boura01/jeu_du_moulin_2025_boura/README.md

c'est le projet Jeu du moulin pour les TPI 2025
voila.
