boura01/jeu_du_moulin_2025_boura/jeu_du_moulin_boura/cdc/readme.md

# Dossier "cahier-des-charges"

 Contient le cahier des charges du projet ainsi que toutes les informations nécessaire à sa compréhension.
