boura01/jeu_du_moulin_2025_boura/jeu_du_moulin_boura/fab/readme.md

# Dossier "project-fab-vx.x.x"

 Contient les fichiers de fabrication du projet.
 Ce répertoire ne contient que des fichier .pdf ou .zip.
 Tous les fichiers sont renommés avec la version de ceux-là.
 L'identification majeur et mineur sont tous identiques.
 Le majeur exprime la version du cahier-des-charges.
 Le mineur exprime la révision du PCB.
 Le patch est propre à chaque fichier indépendemment.

 example:
 
 projectname-pcb-schematic-v1.1.3.pdf
 projectname-pcb-layout-implantation-top-v1.1.0.pdf
 projectname-pcb-layout-implantation-bottom-v1.1.0.pdf
 projectname-pcb-gerber-v1.1.0.zip
 projectname-pcb-bom-v1.1.18.zip
 projectname-fwr-main-v1.1.4.zip
