boura01/jeu_du_moulin_2025_boura/jeu_du_moulin_boura/pcb/gerber/readme.md

# Dossier "gerber"

 Contient les derniers fichiers gerber créés.
