boura01/jeu_du_moulin_2025_boura/jeu_du_moulin_boura/pcb/pdf/readme.md

# Dossier "pdf"

 Contient les derniers fichiers pdf créés.
 
 example:
 
 projectname-pcb-schematic.pdf
 projectname-pcb-layout-top-implantation.pdf
 projectname-pcb-layout-top-implantation.pdf
