boura01/jeu_du_moulin_2025_boura/jeu_du_moulin_boura/rpt/datasheet/readme.md

# Dossier "datasheet"

 Contient tous les datasheets externes pour la création du projet.
 
 Un datasheet peut être utilisé pour du pcb, pour du fwr, pour du rpt, c'est pourquoi on place les datasheets dans ce répertoire spécifique
