boura01/jeu_du_moulin_2025_boura/jeu_du_moulin_boura/rpt/jeu-du-moulin-bourquenouda-rpt-development.docx

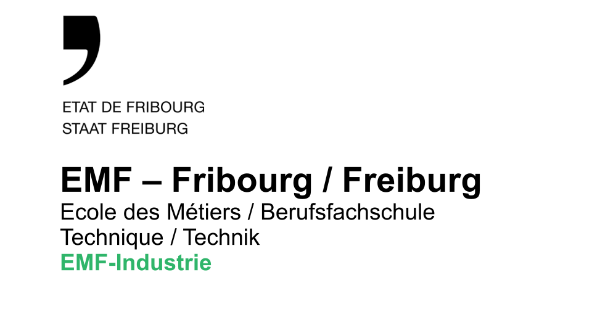
[picture p1: figure]

ELECTRONICIEN/NE CFC
ELEKTRONIKER/IN-EFZ

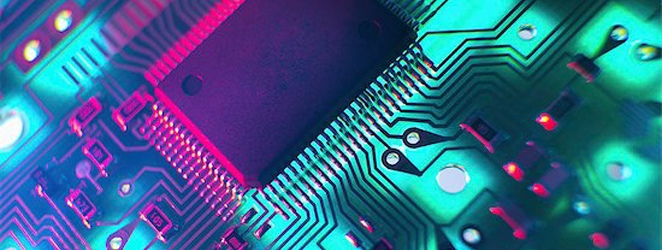
[picture p2: figure]
Le secteur de la technologie en Bourse

Jeu du Moulin 2025

V1.00

Jeu du moulin

Métier, Beruf

Bourquenoud Alexandre

2025

EMF - Ecole des Metiers de Fribourg

SWITZERLAND

# Table des matières

# 1 Information

## 1.1 Objectifs du projet

L’objectif de ce projet est de concevoir un prototype fonctionnel d’un PCB permettant de jouer au jeu du moulin. Cet objet pourra être utiliser par l’EMF pour promouvoir le métier d’électronicien pendant les journées portes ouvertes ou autre évenements. J’ai pu m’appuyer sur une première version du PCB non terminer créé par M.Egli pour pouvoir l’utiliser comme fondation du projet.

Pour démontrer le fonctionnement du projet, je ne suis pas tâché de recréer les règles du jeu du moulin en lui-même, mais plutôt de montrer que chaque touche et sa LED est fonctionnel.

### 1.1.1 Résumé du cahier des charges

Je dois créer le prototype du jeu du moulin sur PCB en continuant et finissant le travail commencer par M. Samuel Egli et créer un code pour démontrer le fonctionnement du prototype en lisant les touches et en allumant les LEDs en fonction des touches. La programmation de l’uC se fera grâce à un connecteur TC2030.

Pour ce faire je devrais adapter le schéma déjà fourni d’un STM32L072RBT à un MCU STM32L072CZU6 et rajouter les composants manquants en suivant certaines contraintes et la norme IEC 60617.

À cause du nombre insuffisant de pins de l’uC pour contrôler chaque touches et LEDs une part une, Je devrai utiliser 2 systèmes de matrices (une pour les LEDs et une pour les touches capacitives).

Je dois utiliser des composants SMD et des boitiers 0603 pour ne pas avoir d’agrandissement optique du montage.

Pour l’alimentation du circuit, je dois utiliser un USB-C ou une alimentation à 5V par 2 connecteurs et ensuite réguler la tension pour avoir un VCC = 3.3V.

Le PCB a des dimensions imposées de 10cm x 10xm mais ses dimensions peuvent être changées si nécessaire. La majorité du circuit de contrôle des touches et des LEDs sera placé sur la face BOTTOM au centre de la plaque pour l’esthétique qui est essentiel au projet.

## 1.2 Schéma de principe de l'environnement

### 1.2.1 Description des blocs principaux

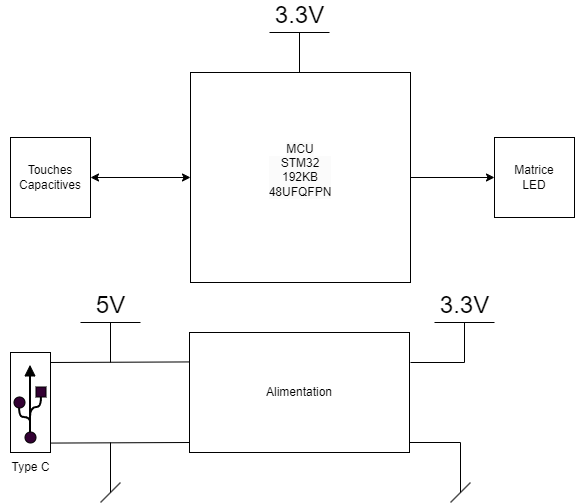
[picture p3: figure]

Le fonctionnement du projet est basé sur 4 parties principales.

1 : Touches capacitives.

Ces touches seront utilisées pour manipuler les pions des joueurs. Le but de mon projet n’étant pas d’avoir un jeu fonctionnel, elles ne serviront qu’a changer les LEDs d’état. Elles sont organisées en matrice pour pouvoir avoir plus de contrôle en utilisant moins d’IO.

2 : Microcontrôleur STM32L072CZU6

Ce microcontrôleur sera utilisé pour commander toutes les parties de l’objet. Contrairement au matériel utilisé d’habitude, celui-ci sera un STM32 et non un PIC.

3 : LEDs

Ces LEDs indiqueront le positionnement et l’équipe du joueurs. Elles seront contrôlées par l’IC et à l’aide des touches capacitives.

4 : Alimentation

Cette partie a comme entrée 5V venant soit d’un câble USB-C soit d’une alimentation de laboratoire et sortira 3.3V à l’aide d’un régulateur linéaire. J’ai aussi choisi d’inclure une protection de polarisation inverse en cas d’erreur de connexion de l’alimentation de laboratoire.

# 2 Planification

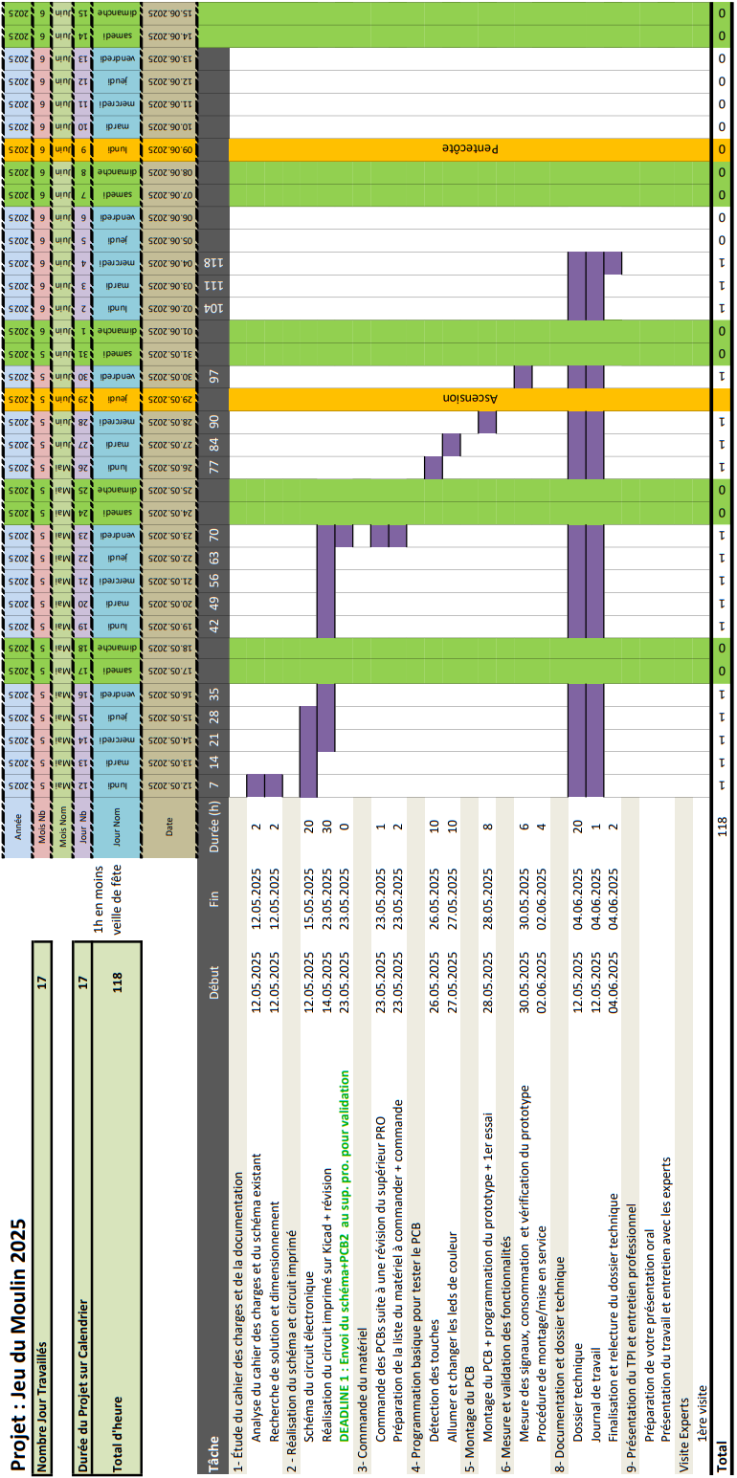
[picture p4: figure]

## 2.1 Calendrier prévisionnelle des tâches à réaliser

## 2.2 Calendrier réel des tâches réalisées

# 3 Décision

Date | Qui | Quoi | Pourquoi
13.05.2025 | Bourquenoud Alexandre, Egli Samuel, Cunha Fabio | Changement de boitier de l’µC | Pour avoir plus de place pendant le layout.
16.05.2025 | Bourquenoud Alexandre | Changement du type d’µC | Plus de stock pour l’autre microcontrôleur que j’utilisais.

# 4 Réalisation

## 4.1 Schéma bloc de l'électronique à développer

Pour le schéma bloc, je me suis inspiré de celui qui m’était imposer car il contient déjà la majorité des choses nécessaires. Le voici :

Changements si nécessaire :

J’ai uniquement modifié le bloc régulateur en alimentation car je compte y ajouter une protection de circuit en cas de polarisation inverse basée sur un MOSFET canal P.

## 4.2 Description des éléments principaux

### 4.2.1 Généralité sur les Touches Capacitives

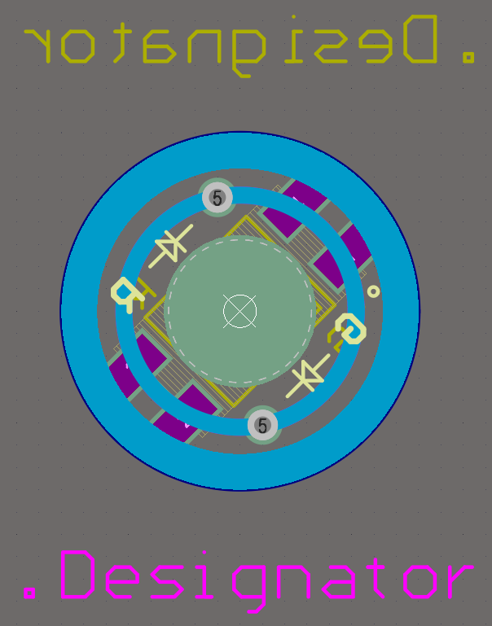
[picture p5: figure]

Elles sont créées directement sur le PCB à l’aide d’empreintes spécifiques qui engendre une capacité. Cette capacité variera si un doigt est présent sur la touche.

Pour détecter si la touche est pressée ou non on utilise un autre condensateur de valeur connue (Cs, Condensateur de sampling, ou échantillonnage en français).

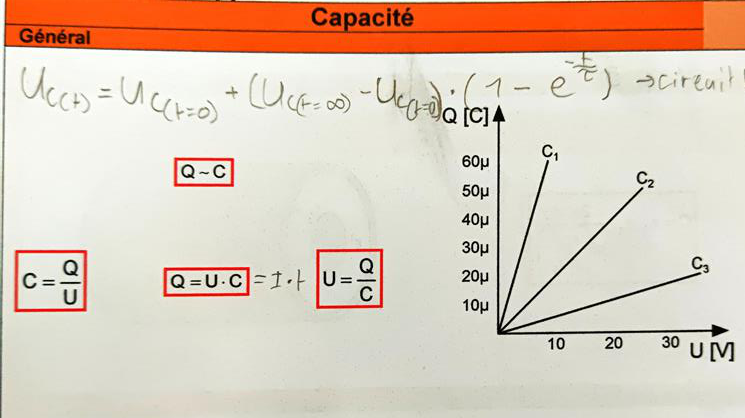
[picture p6: figure]

La méthode de détection est la suivante : On charge la capacité de la touche en la soumettant à une tension constante, puis on transfert cette charge sur le condensateur d’échantillonnage en fermant le circuit de manière que le condensateur chargé soit en série avec Cs. Après l’équilibrage des charges, on mesure la tension aux bornes de Cs et ou pourra déterminer si un doigt est présent sur la touche. Cette tension est ensuite passé à travers un CAN et est finalement interprété par le MCU en fonction des paramètre sélectionnés.

Avec cette formule, on peut voir la relation entre la tension, la capacité et les charges dans les condensateurs.

On a donc un schéma équivalent qui ressemble à peu près à ça :

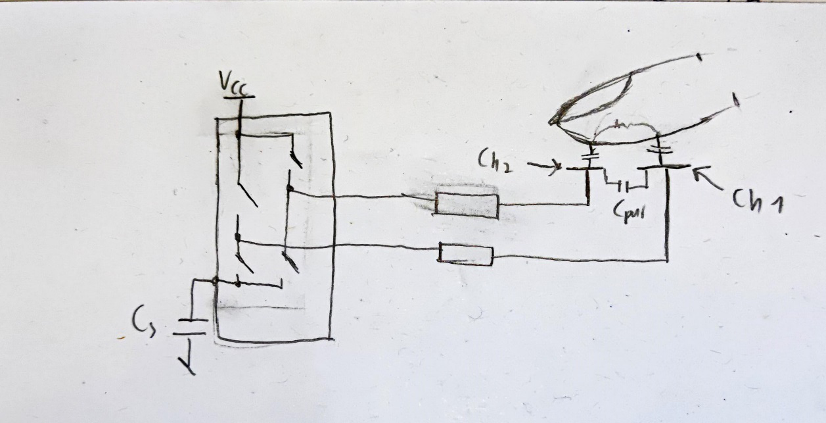
[picture p7: figure]

Ch1 et Ch2 sont les 2 anneaux présent sur l’empreinte du PCB, Cpar est la Capacité parasite et Cs est le condensateur de sampling.

On pourra donc voir que la tension UCs change en fonction de la capacité de la touche qui elle-même change en fonction de si la touche est pressée et aussi de qu’est ce qui presse sur la touche à cause de la constante diélectrique différente des matériaux.

Avec le système de matrice que nous utilisons, un problème peut se produire quand plusieurs touches des mêmes canaux sont pressées en même temps :

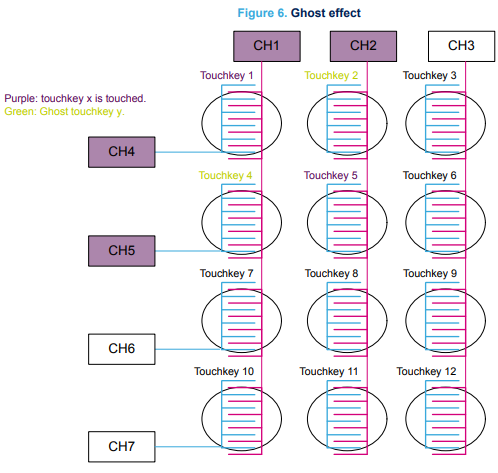
[picture p8: figure]

Dans cet exemple, la touche 1 et 5 est touché or le microcontrôleur ne peut pas différencier si les touches 1,2,4 ou 5 ont été pressé.

Ce problème est documenté par STMicroelectronics et dans notre cas ne sera pas trop important car dans le jeu, uniquement une touche doit être pressée à la fois.

Je voulais inclure un calcul de la capacité des touches, mais après une conversation avec M. Berset, je me suis rendu compte que ce n’était pas nécessaire au fonctionnement des touches et très bancal.

### 4.2.2 Généralité sur le MCU STM32 UFQFPN48

Le modèle de microcontrôleur imposé était "STM32L072CZT6" mais il a été changé quelques fois à cause de plusieurs raisons : le premier changement était dû à la taille et le deuxième a cause d’un manque de stocks. On a changé de boitier de LQFP48 à UFQFPN48 pour avoir plus d’espace de routage au centre du PCB ce qui nous a conduit au modèle "STM32L072CBU6". M.Egli utilisait ce MCU dans la programmation, ce qui convenait. Quand j’effectuais la recherche des composants pour la commande, je n’ai pas pu trouver le modèle utiliser dans le code de M.Egli alors j’ai choisi d’utiliser un modèle similaire après avoir vérifié la compatibilité ce qui nous a conduit au "STM32L072CZU6" qui fonctionne autant bien que les autres pour notre application. Avec une matrice, 24 touches donnent une utilisation de onze pins. Sur le MCU on a 6 groupes de touch sensing avec deux ou trois touches par groupes. Chaque groupe est composé de 4 pins dont un groupe ne contenant que 3 pins une de ces pins doit être utilisé pour le condensateur d’échantillonnage ce qui réduit le nombre de touches valables à trois et dans dans le cas du groupe à trois pins au total. J’ai donc employé 4 groupes de touch sensing pour les touches capacitives. Le PCB a une LED par touche donc on a aussi 24 LEDs qui seront organisé en matrice.

### 4.2.3 Généralité sur les LEDs AAA3528SURKCGKC09

Ces composants sont des LEDs bicolores de couleur rouge et vert produites par Kigbright. Elles sont utilisées pour montrer quel joueur est en possession de la case -> Rouge pour un joueur, vert pour l’autre et orange/rien quand la case est vide. Éteindre les LEDs quand la case est inoccupée pourrait s’avérer être une meilleure solution pour sauver des opérations du MCU. La LED rouge fonctionne avec une tension typique de 1.95V et un courant de 20mA, sa tension max est de 2.5V tandis que la LED verte consomme 20mA à 2.1V typ. Avec le même maximum de 2.5V. voici le Pinout du composant prit dans le datasheet.

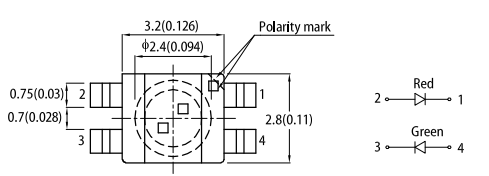
[picture p9: figure]

Idéalement, pas plus que deux LEDs (donc un de ces composant) seront allumé en même temps pour ne pas demander une consommation de courant trop élevée. Je vais utiliser un code que j’ai écris il y a un moment pour gérer les LEDs de façon qu’on ait l’impression que toutes les LEDs allumé le soit en même temps. Pour ce faire je dois simplement les allumer puis éteindre dans un ordre de manière plus rapide que la perception humaine. Je dois garder en tête que les touches capacitives sont aussi dépendantes d’une interruption donc il est possible que le fonctionnement correct de la matrice soit compromis.

## 4.3 Schématique, Dimensionnement & simulation

### 4.3.1 Schématique globale

J’ai aussi récupéré une schématique partiellement complète de Monsieur Egli mais il avait utilisé un autre IC que celui qui m’était imposer alors j’ai dû le changer. Ce schéma sera situé en annexe en cas de besoin de comparaison. Voici ci-après les schémas après mes changements avec des commentaires sur la raison des changements.

### 4.3.2 Changements Apportés au schéma de base

On peut voir que sur la première page, j’ai rassemblé les parties en groupes qui sont les même que dans le schéma bloc plus le connecteur TC2030 pour programmer le STM32L072CZU6 qui contrôlera la matrice de LEDs et de touches et que j’ai séparé les deux matrices sur deux pages différentes.

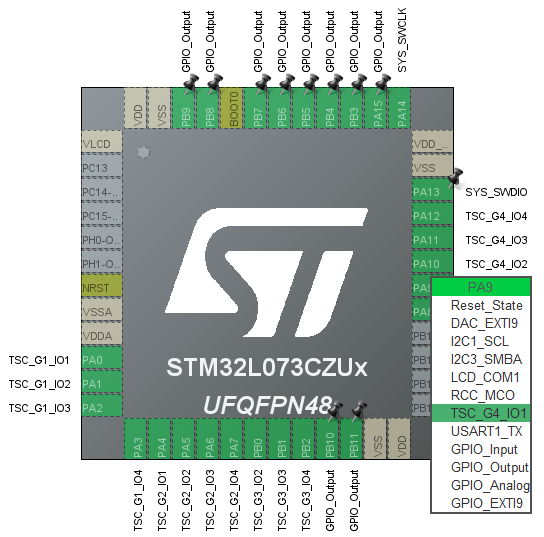
[picture p10: figure]

Groupe 1 : Microcontrôleur. Dans ce groupe, j’ai ajouté toutes les connexions des deux matrices et les condensateurs de découplage. J’ai été porté à faire des modifications dans la partie découplage pour être conforme aux instructions demandées par STMicroelectronics car le MCU imposé dans mon cahier des charges n’était pas le même que celui que M. Egli a utilisé dans le schéma de son prototype. J’ai contrôlé quelles pins sont valables à être utilisé à l’aide du logiciel STM32CubeIDE. Voici le paramétrage que j’ai utilisé pour voir si on avait assez de pins pour le jeu et pour voir quels pins étaient disponible.

On peut voir que les pins utilisés dans le schéma sont différents. C’est parce-que j’ai utilisé la méthode du pin-swapping sur Altium qui facilite le routage en me permettant de changer quelle pins est utiliser en les classant dans des groupes différents. Par exemple, toutes les pins des touches peuvent être interchangé car ce sera juste a la programmation qu’il faudra faire attention à quelle pin contrôle quoi. C’est pareil pour les LEDs, ce sera qu’au moment de la programmation que savoir quelle pin contrôle les colonnes ou les lignes de la matrice.

Avec ce panneau :

On peut voir comment la pin pourra être utiliser. J’ai donc utilisé ces informations pour savoir quels groupes faire. J’ai fait trois groupes (A, B et C) de pin-swapping. Le groupe A sert pour les 11 inputs des touches capacitives, le groupe B sert au contrôle de la matrice de LEDs et le groupe C est pour les condensateurs de sampling et les point de test. Comme je l’avais dit avant, toutes les pins de chaque groupes sont interchangeable car ce sera gérer niveau software donc je prends avantage de cette méthode pour faciliter le routage. Voici la fenêtre de pin-swapping :

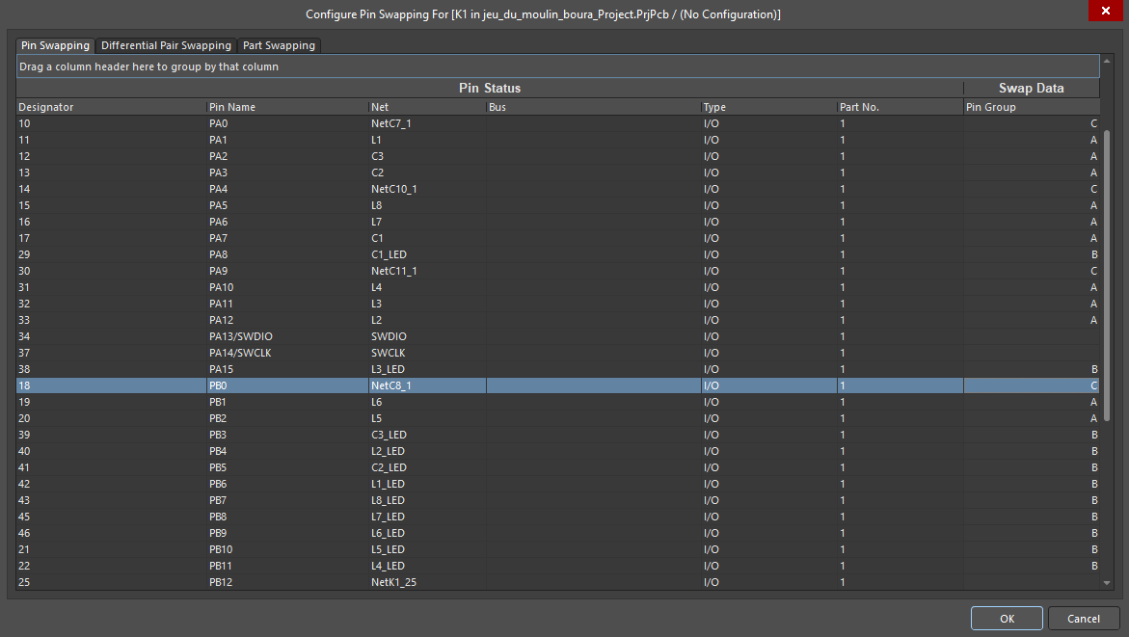
[picture p11: figure]

Un autre aspect qui diverge par rapport au schéma de base, c’est que j’ai rajouter des points de test TP3, 4, 5 et 6. Avec ces points, j’espère pouvoir mesurer les changements de tension quand on change la capacité en approchant sont doigt

Groupe 2 : Connecteur de programmation. Ce groupe n’existe pas dans le schéma bloc, mais il consiste juste des connexions nécessaires à la programmation du MCU. Cependant, le connecteur qu’on m’impose, un TC2030 qui demande juste des pads en surface et non un composant entier, n’est pas le même que celui du premier schéma et j’ai donc dû modifier cette partie du schéma.

Groupe 3 : Matrice de touches. Je n’ai pas apporté beaucoup de changements dans la matrice de touches, je l’ai simplement complété pour avoir les 24 touches nécessaires au fonctionnement du jeu du moulin.

Groupe 4 : Matrice de LEDs. Là aussi, j’ai simplement terminé la matrice de LEDs en suivant la même logique utilisée pour le schéma de M.Egli.

Groupe 5 : Alimentation. Cette partie était dans le schéma bloc mais absente dans le prototype de M.Egli et j’ai donc dû la créer entièrement. En lisant le cahier des charges on m’a dit qu’il fallait une tension d’alimentation de 5V réguler à 3.3V pour le MCU et le reste de la commande. J’ai donc cherché un régulateur qui serait utilisable et ensuite j’ai recherché des circuits de protection à la polarisation inversé. Un papier du fabricant Onsemi m’a été recommandé par mon frère au sujet des différent types de protection et je l’ai utilisé pour créer et dimensionné mon circuit de protection. Il est composé d’une diode zener, d’une résistance et d’un MOSFET canal P. Le fonctionnement est décrit dans l’article (AND90146 - MOSFET Selection for Reverse Polarity Protection (https://www.onsemi.com/download/application-notes/pdf/and90146-d.pdf)) mais globalement, en fonctionnement normale, Le MOSFET est polarisé par une tension imposée par la tension zener de la diode et le courant traversant la diode est lui-même limité par la résistance. En quand la polarité est inversée, la tension G-S du MOSFET serait bloqué à ~0.7V ce qui empêche le MOSFET de conduire et amène la chute de tension D-S à augmenter et empêche le circuit de subir une chute de tension inverse de plus de quelques microvolts. J’ai fait une simulation sur Falstad pour démontrer le fonctionnement du circuit de protection :

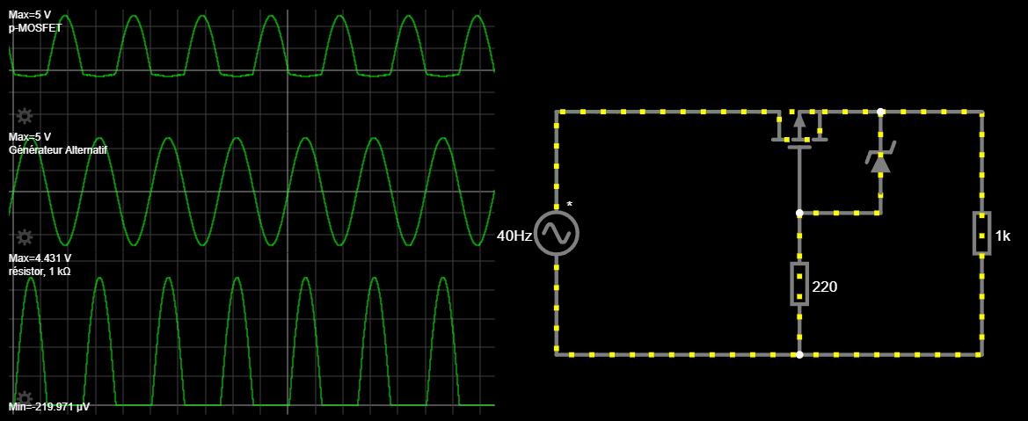
[picture p12: figure]

On peut donc voir sur la simulation que quand la tension du générateur est en alternance négative, la tension de la résistance de charge de 1kΩ ne passe jamais en dessous des -219.971µV et celle du MOSFET monte à 5V en revanche, entre le générateur et la charge, on a une chute de tension de 0.569V. Cette chute n’est pas très importante car 1 : elle dépend du MOSFET choisi et 2 : la tension de sortie du régulateur est de 3.3V.

Pour le connecteur USB-C il m’a fallut ajouter deux résistances de pull-down de 5.1kΩ sur les lignes CC pour signaler à la source de ne pas agir autrement que de fournir 5V et 500mA.

### 4.3.3 Dimensionnement

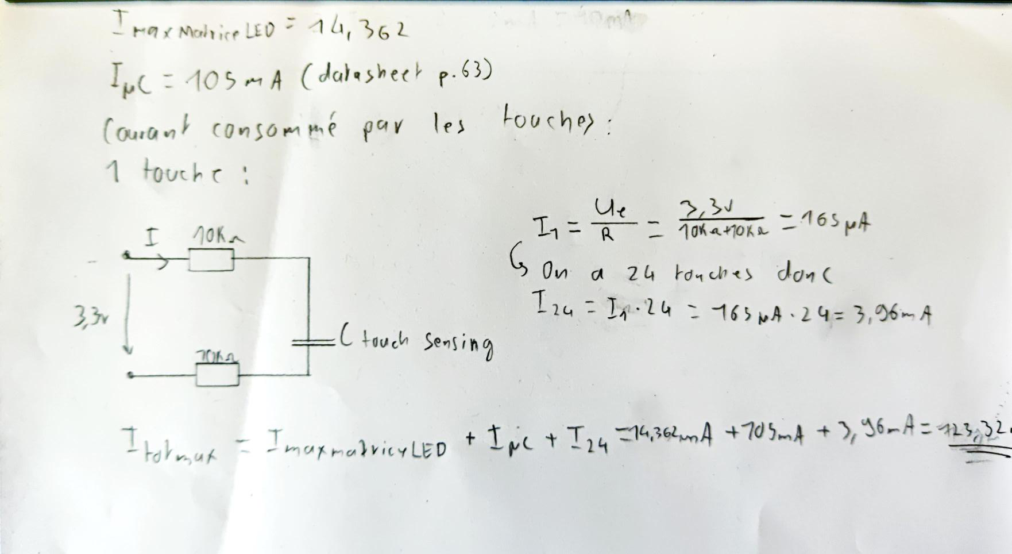
[picture p13: figure]

#### 4.3.3.1 Estimation du courant de consommation du système

J’ai estimé la consommation maximum de tout le circuit dans le pire cas possible en la séparant vers les principaux groupes de consommation. J’ai été forcé d’ignorer le condensateur de touch sensing car il est très difficile de calculer une valeur précise de sa capacité ce qui conduira forcément à des valeurs de calcul différentes de celle de mesure.

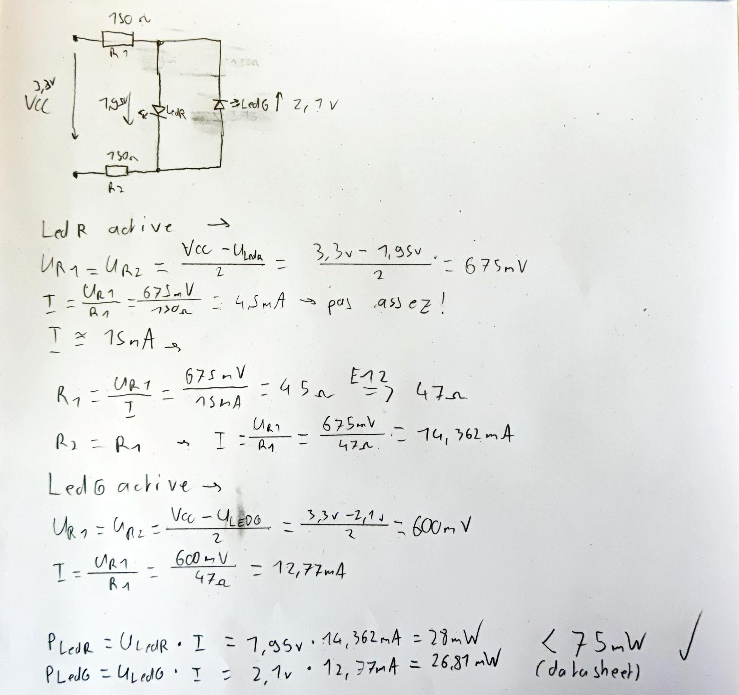
[picture p14: figure]

Et voici le calcul utilisé pour estimer la valeur du courant consommé par les LEDs :

#### 4.3.3.2 Régulateur de tension

La valeur en tension m’a été demandé à 3.3V mais j’ai dû calculer le courant maximum avant de pouvoir la mesurer. Je suis donc aller voir dans les cas extrêmes pour l’uC ce qui nous donne un courant max de 105mA (Datasheet - STM32L072x8 STM32L072xB STM32L072xZ - Ultra-low-power 32-bit MCU Arm®-based Cortex®-M0+, up to 192KB Flash, 20KB SRAM, 6KB EEPROM, USB, ADC, DACs (https://www.st.com/resource/en/datasheet/stm32l072v8.pdf) P.63). Les deux autres matrices utiliseront aussi du courant donc j’ai fait des calculs pour les cas extrêmes de leur côté aussi. Pour la matrice de LEDs, on pourra activer un maximum de 2 LEDs à la fois. Avec la matrice de touches, j’estime que toutes les touches tireront le courant maximum en tout temps.

Il me faudra donc un régulateur qui a la capacité de fournir plus de 146mA.

#### 4.3.3.3 Résistance pour le port USB-C

Il n’y a que 2 résistances sur le port USB-C car on l’utilise uniquement comme source et non pour effectuer des transferts de donnés. On m’a conseillé de regarder en ligne pour trouver la valeur des résistances qu’on doit utiliser comme pull-down. J’ai donc trouvé des informations sur un forum qui recommandais d’utiliser deux résistances de 5.1kΩ sur les 2 lignes de CC.

#### 4.3.3.4 Microcontrôleur

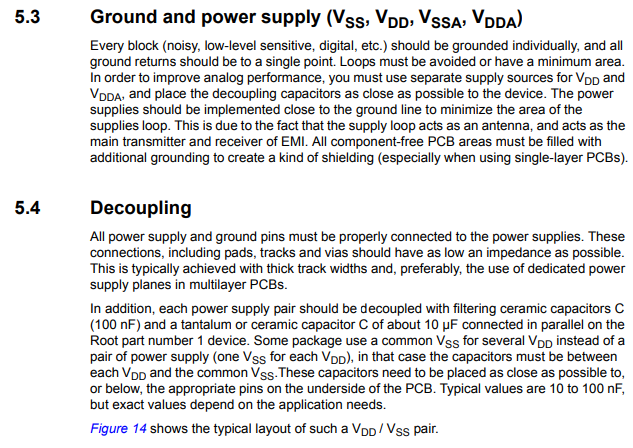
[picture p15: figure]

Pour le dimensionnement des condensateurs de découplage, toutes les informations nécessaires étaient fournies la documentation officielle de ST (Getting started with STM32L0xx hardware development (https://www.st.com/resource/en/application_note/an4467-getting-started-with-stm32l0xx-hardware-development-stmicroelectronics.pdf)):

##### 4.3.3.4.1 Port mapping

Pour le mapping des ports, j’ai regardé quelles pins était utilisé pour la programmation dans le datasheet et j’ai ensuite utilisé STM32CubeIDE pour savoir quelle pin pouvait être pour le touch sensing et j’ai assigné les pins restantes à la matrice de LEDs. Le mapping des LED a été fait avec le resultat du routage Altium car avec le pin-swapping utilisé pour convenir aux contraintes du cahier des charges on change facilement l’assignement des pins par rapport au schéma de base.

#### 4.3.3.5 Protection contre polarisation inverse

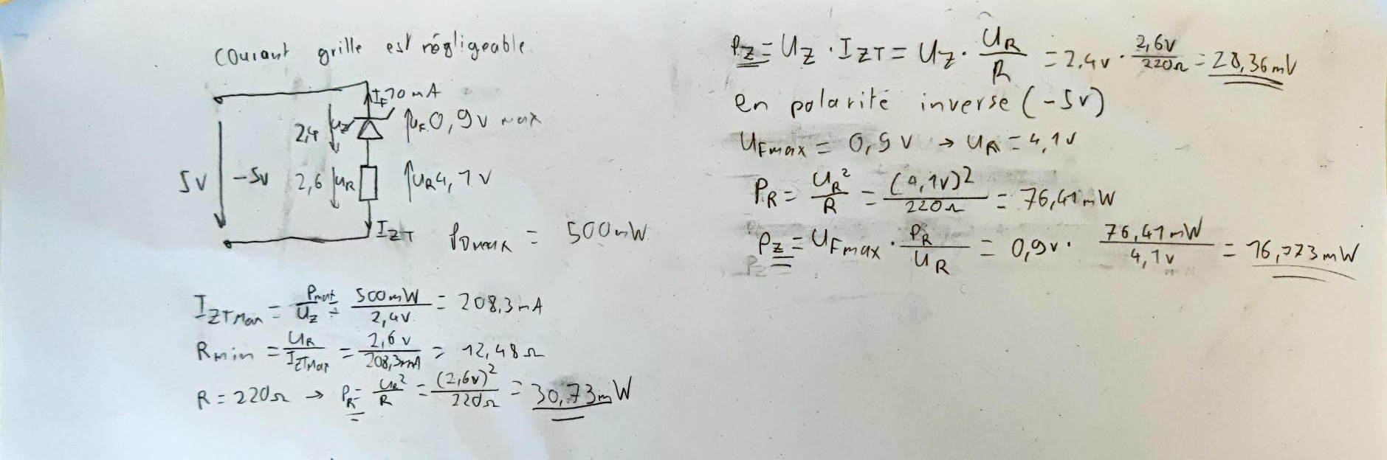
[picture p16: figure]
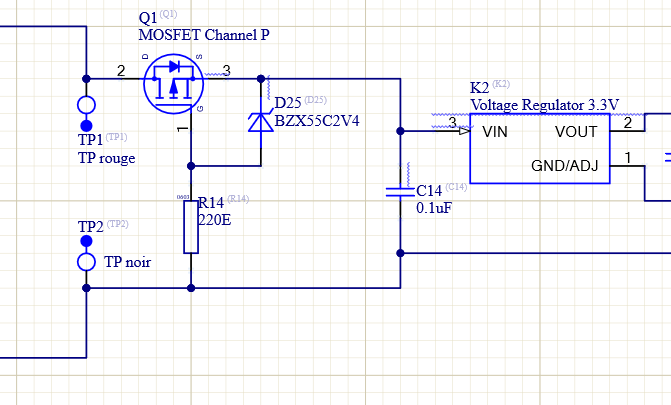
[picture p17: figure]

Pour la protection du circuit contre une polarisation inverse des TP1 et TP2, j’ai choisi d’utiliser un MOSFET channel P avec cette configuration :

Suggérer par le papier de ONSEMI sur la sélection des MOSFET pour la protection de polarisation inverse (AND90146 - MOSFET Selection for Reverse Polarity Protection (https://www.onsemi.com/download/application-notes/pdf/and90146-d.pdf))

J’ai donc du dimensionné la diode ZENER D25 et la résistance R14 pour qu’en polarisation correct, la Zener conduise et donc fait conduire le MOSFET en imposant la tension de seuil UGS sur la Grille et la source. En lisant le datasheet, j’ai choisi une diode Zener 2.4V 0.5W en boitier SOD-123 et j’ai simplifier le schéma de manière a pouvoir calculer R14.

## 4.4 Rédaction du protocole de mise en service du prototype

### 4.4.1 Protocole de mise en service

Etape | Quoi faire | Valeur attendue | Valeur mesurée | Erreur | Validée | Mes. Ref.
1 | Testez la continuité des GND | - | - | - | OK | -
2 | Implantez tous les composants SMD de la face BOTTOM | - | - | - | OK | -
3 | Vérifiez que le switch bloque la sortie du régulateur en vérifiant qu’il n’y ait pas de continuité entre TP7 et TP8 | Pas de beep | - | - | OK | -
4 | Alimentez le circuit par source de laboratoire en 5V. Sonde positive sur TP1 et sonde négative sur TP2. | - | - | - | OK | -
5 | Mesurez la tension de sortie du régulateur depuis le TP7 jusqu’au GND au TP2 | 3.3V | 3.270V | % | OK
6 | Vérifiez que le switch bloque la sortie du régulateur en vérifiant qu’il n’y ait pas de continuité entre TP7 et TP8 | Pas de beep | - | - | OK | -
7 | Alimentez le circuit par source de laboratoire en 5V. Sonde positive sur TP2 et sonde négative sur TP1 et mesurez la tension de sortie du régulateur depuis le TP7 jusqu’au GND au TP2 | 0V | 12.8mV | % | OK
8 | Déconnectez la source de laboratoire et braser le port USB-C. | - | - | - | OK | -
9 | Vérifiez que le switch n’est toujours pas fermé avec un test de continuité TP7 et TP8 | Pas de beep | - | - | OK
10 | Connectez un cable USB-C au port USB-C | - | - | - | OK | -
11 | Mesurez la tension TP1-TP2 | 5V | 5.15V | % | OK
12 | Mesurez la tension TP7-TP2 | 3.3V | 3.299 | % | OK
13 | Mesurez le courant TP7-TP8 | 8mA-123mA | | -
14 | Déconnectez le cable USB-C et changer actionner le switch S1 | - | - | - | | -
15 | Vérifiez que le switch est fermé avec un test de continuité entre TP7 et TP8 | beep | beep | - | OK | -
16 | Connectez le connecteur de programmation | - | - | - | OK | -
17 | Reconnectez le cable USB-C | - | - | - | OK | -
18 | Vérifiez qu’on peut connecter le PCB à STM32CubeID en lançant un debug | STM32CubeIDE ne donne pas de message d’erreur | Pas d’erreur si le debugger utilise le type Hardware reset et la fréquence 1000 au lieu d’auto | - | OK | -
19 | Lancez le debugger en mettant en commentaire les lignes concernant le contrôle des LEDs | STM32CubeIDE ne donne pas de message d’erreur | Problème de détection des touches | - | NOK | -
20 | Vérifiez dans le Live Expression de l’IDE que les touches fonctionnent en les pressant et observant s’il y a une réaction dans la variable de type tableau nommée touchDetect | La case du tableau correspondant à la touche doit changer de 0 à 1 quand on la presse. | Problème de détection des touches | - | | -
21 | Relancez le debugger en incluant les lignes concernant le contrôle des LEDs | STM32CubeIDE ne donne pas de message d’erreur | - | - | OK | -
22 | Vérifiez que les LEDs s’allument, changent de couleurs et s’éteignent quand les touches sont pressées, | Les LEDs fonctionnent correctement | Problème de détection des touches | - | NOK | -
23 | Lancez le programme de test de LEDs LED_TEST | La matrice de LEDs doit être fonctionnel. | - | - | OK | -

### 4.4.2 Mesure1

#### 4.4.2.1 But de la mesure

Cette mesure a comme but de nous donner la valeur du courant que le système consomme quand il effectue une détection des touches capacitives sur le prototype de M.Egli.

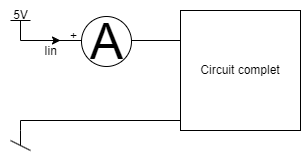
[picture p18: figure]

#### 4.4.2.2 Schéma de mesure

#### 4.4.2.3 Liste des instruments et leurs réglages

Instrument | Modele | Réglage
Alimentation de laboratoire | Xantrex XPL 30-2T Triple DC Power Supply | 3.3V, 300mA
multimètre | Amprobe 34XR-A | Courant DC mA

#### 4.4.2.4 Tableaux des valeurs mesurées

Iin = 8mA

#### 4.4.2.5 Conclusion

La valeur mesurée diffère grandement de la valeur calculée car le prototype de M.Egli n’as pas le même nombre de touches actives en même temps et la capacité des touches ne peut pas être calculé avec précision.

### 4.4.3 Mesure2

#### 4.4.3.1 But de la mesure

Cette mesure a comme but de nous donner la valeur du courant que le système consomme quand il effectue une détection des touches capacitives sur mon prototype.

#### 4.4.3.2 Schéma de mesure

#### 4.4.3.3 Liste des instruments et leurs réglages

Instrument | Modele | Réglage
Alimentation de laboratoire | Xantrex XPL 30-2T Triple DC Power Supply | 3.3V, 300mA
multimètre | Amprobe 34XR-A | Courant DC mA

#### 4.4.3.4 Tableaux des valeurs mesurées

Iin = 7.53mA

#### 4.4.3.5 Conclusion

On peut voir que la valeur mesurée de la consommation de courant des touches est très différente que celle de l’estimation ce qui me porte à croire que le calcul de courant est faux à noter que 2 des 8 lignes (L2 et L3) ne sont pas fonctionnelles au moment de la mesure.

### 4.4.4 Mesure3

#### 4.4.4.1 But de la mesure

Cette mesure a comme but de nous donner la valeur du courant que le système consomme quand il effectue une détection des touches capacitives et que le nombre maximum de LEDs (18) sont allumées sur mon prototype.

#### 4.4.4.2 Schéma de mesure

#### 4.4.4.3 Liste des instruments et leurs réglages

Instrument | Modele | Réglage
Alimentation de laboratoire | Xantrex XPL 30-2T Triple DC Power Supply | 3.3V, 300mA
multimètre | Amprobe 34XR-A | Courant DC mA

#### 4.4.4.4 Tableaux des valeurs mesurées

Iin = 11.34mA

#### 4.4.4.5 Conclusion

On peut voir que l’estimation du courant consommé est bien trop élevé et que le système ne consomme pas grand-chose quand le nombre maximum de LEDs sont allumées. En faisant la mesure sur le circuit, on peut observer un clignotement des LEDs.

## 4.5 Liste de matériel

Voici la Bom du projet :

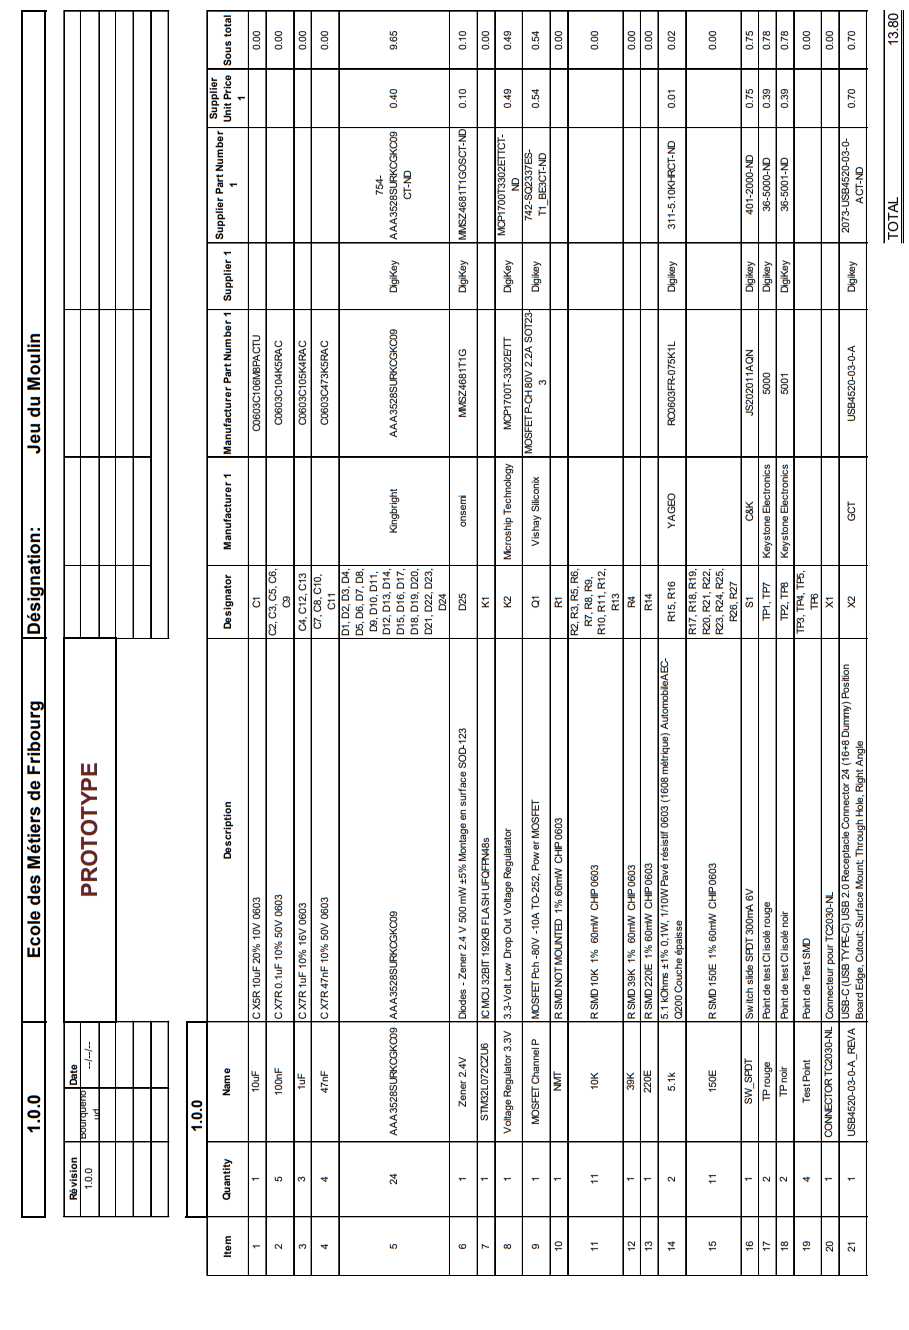
[picture p19: figure]

## 4.6 Layout

Pour le layout, J’ai d’abord placé les composant qui avaient une position imposée par le cahier des charges donc les 24 touches capacitives et leurs LEDs qui doivent être arrangé comme un plateau de jeu pour le moulin, le STM32 qui doit être au centre du PCB, le port USB-C qui doit être dans un bord et le connecteur de programmation qui dois être dans un bord aussi. Après ces composants j’ai dû réfléchir de manière a ce que tous les composants soient placé logiquement -> les condensateurs près des IC (le STM32 et le régulateur) qu’ils découplent, les résistances des matrices doivent être placé logiquement par rapport à leur pin sur le µC tout ça en faisant attention à laisser assez de place pour que les pistes atteignent les pins du STM32.

Ma méthode était la suivante : après avoir placé les composant qui avait une position obligatoire, j’ai collé les condensateurs de découplage le plus proche possible de leurs IC pour ensuite router les touches capacitives entre elles ce qui me permet de savoir quels endroits ne pourront pas être utilisé pour des pistes sur la face TOP. J’ai ensuite routé toute la partie alimentation dans un bord de plaque mais j’ai dû déplacer le switch par la suite. Après avoir router l’alimentation, j’ai relié les touches au MCU en amenant les résistances liées à la colonne ou ligne une part une. J’ai finalisé le routage par faire la même chose pour la matrice de LED. J’ai par la suite dû changer ou passait les pistes de contrôle des LEDs pour ne pas interférer avec les touches capacitives en faisant passer le signal haute fréquence de dessous de celles-ci.

Voici le layout complet (j’ai caché les 2 plans pour une meilleur lisibilité) suivi de quelques commentaires sur le placement des composants.

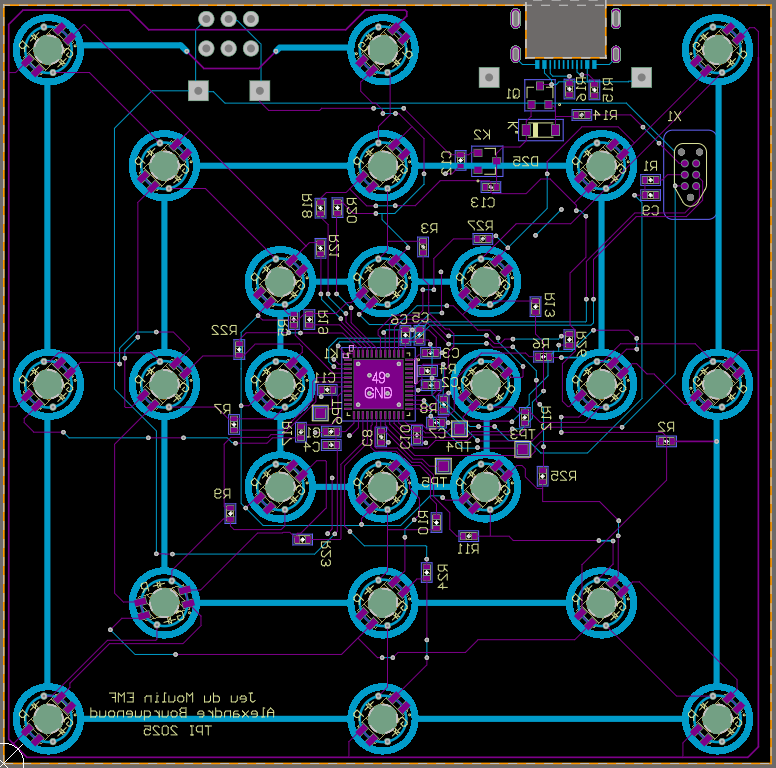
[picture p20: figure]
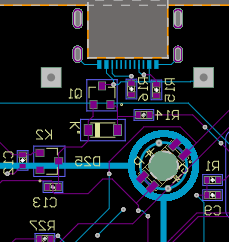
[picture p21: figure]

J’ai placé la partie alimentations près du ports USB-C car il y avait de l’espace dans le routage de la colonne C1 des touches capacitives. On peut y voir le MOSFET canal P , la diode Zener et le régulateur.

Pour la partie microcontrôleur, on a tous les condensateurs de découplage proche du STM32.

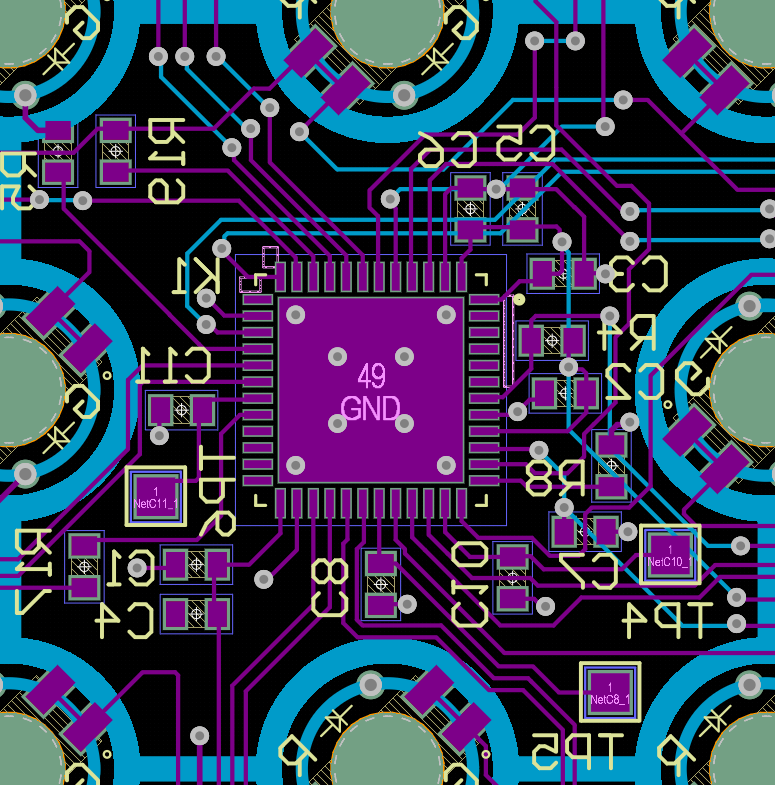
[picture p22: figure]

### 4.6.1 Contraintes (Rules Check)

#### 4.6.1.1 Largeurs des pistes de cuivre

Pour les largeurs de piste, j’ai essayé de suivre la logique de M.Egli en utilisant majoritairement l’épaisseur de 0.16mm pour les pistes des couches BOTTOM et TOP

#### 4.6.1.2 Diamètres des vias

J’ai utilisé 2 types de vias provenant de la bibliothèque de l’EMF. Les 2 ont le même diamètre et la seule différence est qu’une des deux est tented et a donc une couche de solder mask qui ne laisse pas le cuivre à l’air libre.

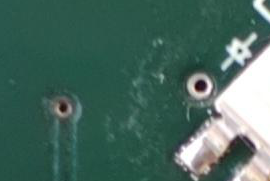
[picture p23: figure]
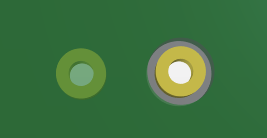
[picture p24: figure]

Tented non Tented

Tented non Tented

Le diamètre de ces vias est de 0.60mm

### 4.6.2 Empreintes spécifiques

La majorité des empreintes utile à ce projet ont été prise depuis la base de données de l’EMF ou depuis divers sites comme SnapEDA. Avant d’utilisé les empreintes, je les ai toutes mesuré sur Altium pour vérifier si elles étaient conformes à leurs dimensions sur le datasheet des composants correspondant.

J’avais besoin d’utiliser une empreinte spéciale fournie par M.Egli qui fera office de touche et LED à la fois en comportant une touche (donc 2 canaux) sur la face TOP et une LED (https://eduetatfr-my.sharepoint.com/personal/alexandre_bourquenoud_studentfr_ch/Documents/PHIE/jeu_du_moulin_alexandre_bourquenoud/jeu_du_moulin_2025_boura/je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) sur la face BOTTOM. Il y a un trou au milieu de l’empreinte pour pouvoir voir l’émetteur de la LED.

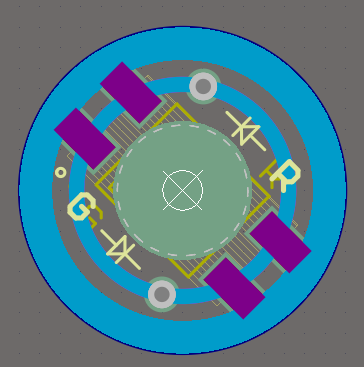
[picture p25: figure]
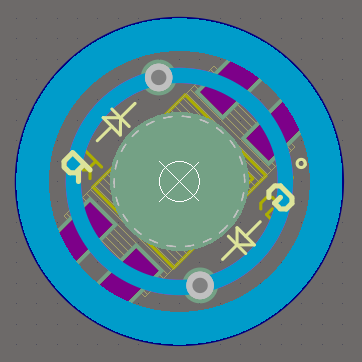
[picture p26: figure]

Face BOTTOM : LED bicolore

Face TOP : 2 canaux des touches capacitives

#### 4.6.2.1 Régulateur de tension

Le régulateur de tension (https://eduetatfr-my.sharepoint.com/personal/alexandre_bourquenoud_studentfr_ch/Documents/PHIE/jeu_du_moulin_alexandre_bourquenoud/jeu_du_moulin_2025_boura/je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) est contenu dans un boitier SOT-23 et est placé dans le coin ou la colonne C1 des touches capacitives n’est pas relié avec le reste et toute la partie alimentation (protection de polarisation inverse, condensateurs de découplage) est basée sur le positionnement du régulateur de tension linéaire 3.3V.

#### 4.6.2.2 Microcontrôleur

Le microcontrôleur STM32L072CZU6 est placé au centre du PCB avec ses condensateurs de découplage placé le plus près possible pour avoir une bonne efficacité. En changeant de boitier pour le µC (de LQFN48 à UFQFPN48), on arrive a gagner une bonne quantité de place au centre.

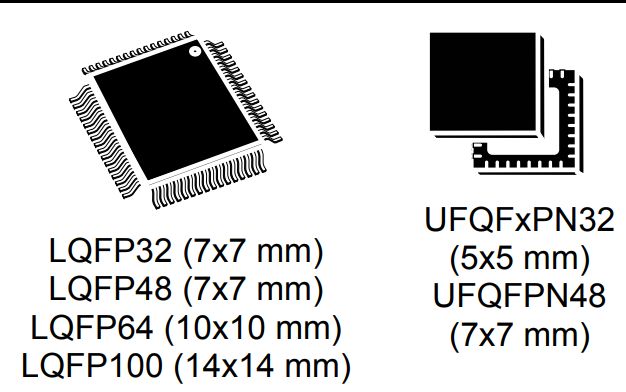
[picture p27: figure]

2 On gagne 2mm de chaque côté en utilisant le UFQFPN48

Ce choix sera très bénéfique car l’empreinte des touches capacitives est relativement contraignante au niveau du layout et du routage à cause de leurs positionnements obligatoire tout autour du µC.

## 4.7 Firmware

### 4.7.1 Programmation des touches

La configuration des touches est faite à l’aide de l’interface graphique de l’IDE stm32CubeIDE. J’ai essayé de baissez le threshold de détection des touches le plus bas possible, mais il était quand même impossible de détecter correctement les touches des colonnes.

Au niveau de la programmation pour interpréter la pression de chaque touches, un code d’exemple est fourni par STMicroelectronics, on l’utilise après avoir apporté quelques modifications pour qu’il fonctionne avec le principe de matrice et non de touche singulière.

Voici les 2 onglets nécessaire au paramétrage des touches capacitives :

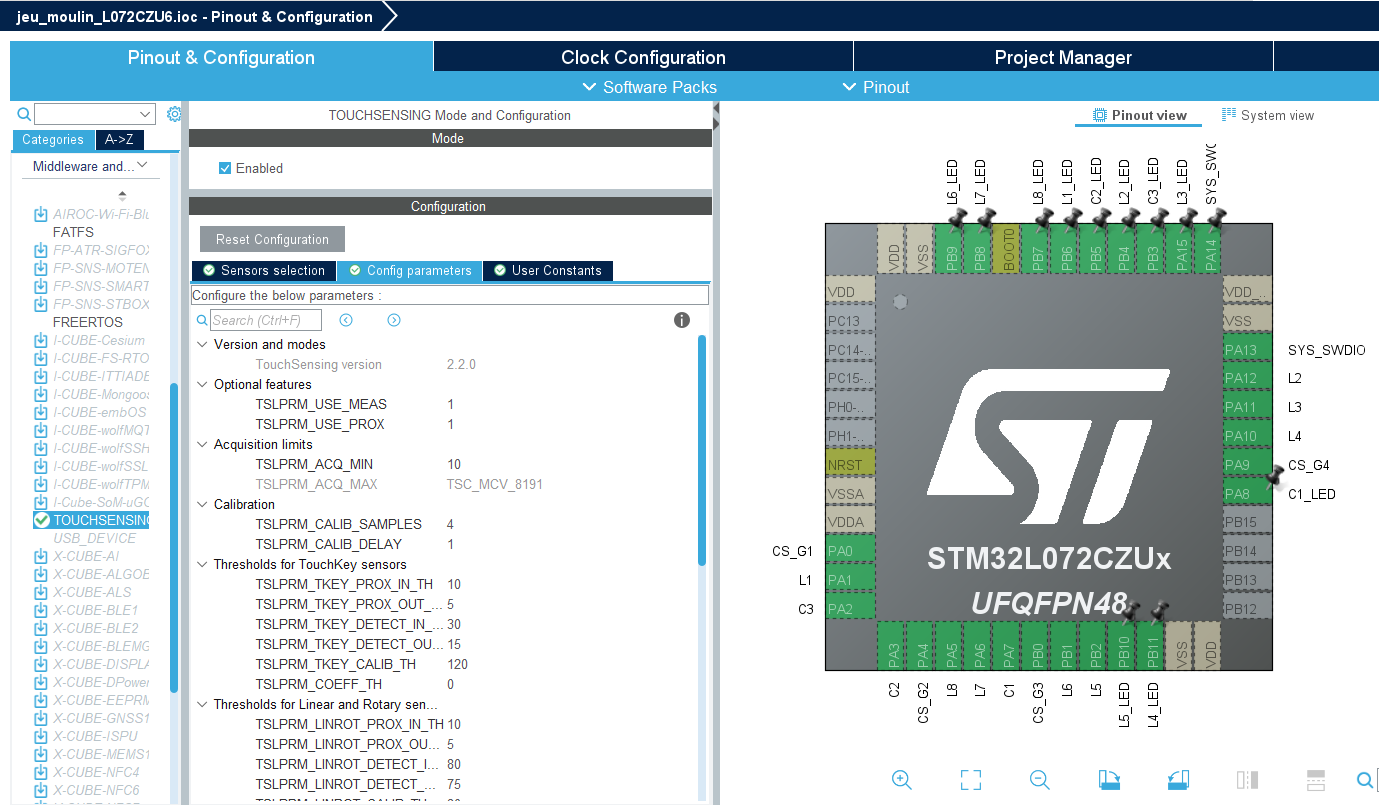
[picture p28: figure]
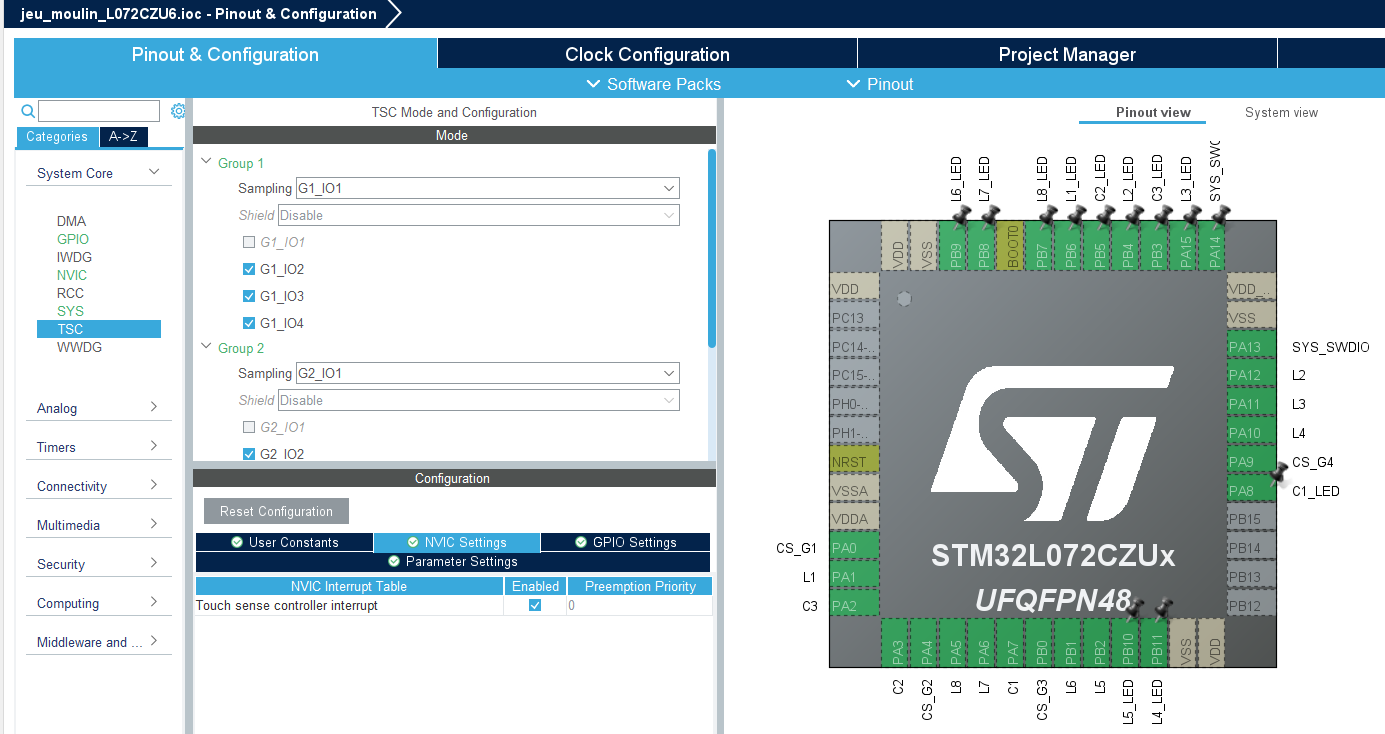
[picture p29: figure]

### 4.7.2 Programmation des LEDs

La configuration des GPIO des pins est aussi faite par interface graphique de l’IDE même si le mode des touches changera d’input à output pendant le déroulement du programme. C’est principalement sous cet onglet qu’on configurera les GPIO des LEDs :

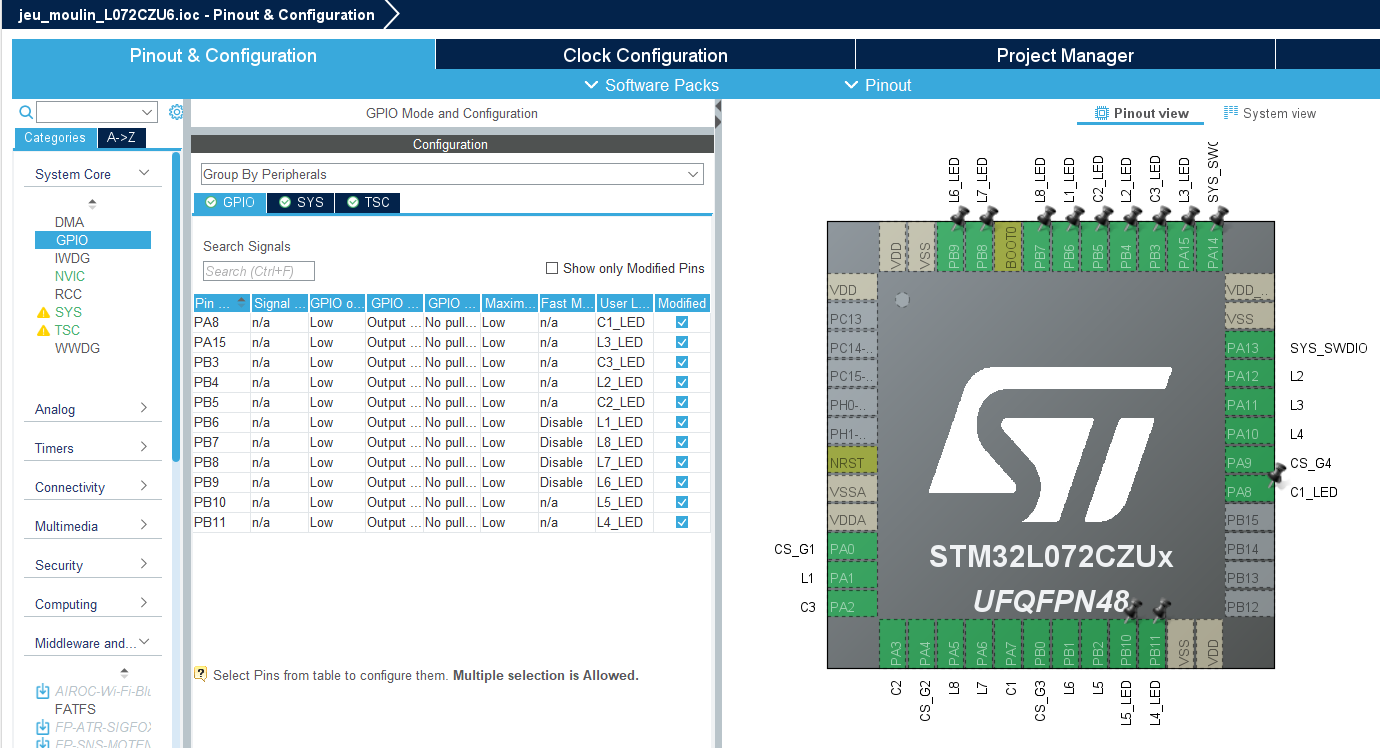
[picture p30: figure]
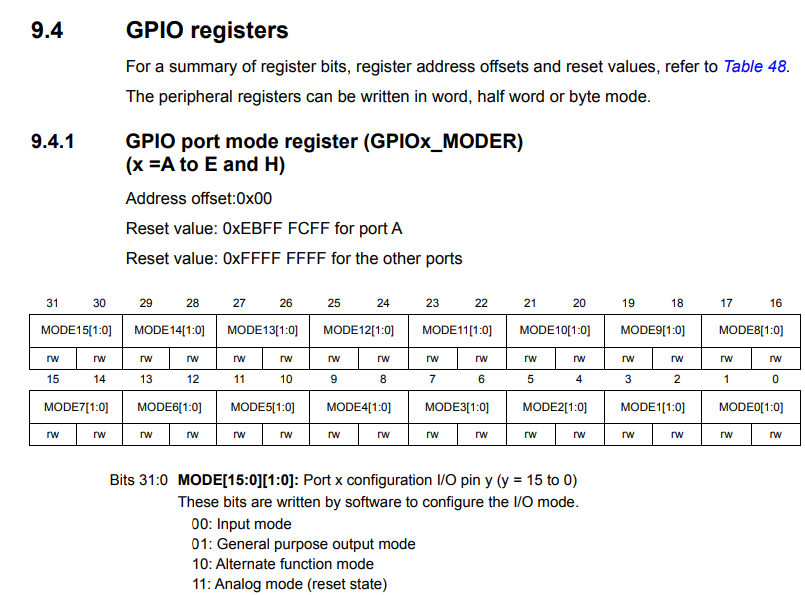
[picture p31: figure]

Pour faire fonctionner les LEDs de manière une par une, je dois changer les pins d’input à output et vice-versa pendant le programme pour ne pas allumer des LED qui ne doivent pas s’allumer. En effet, si on place les LEDs comme dans mon schéma, ce n’est pas possible de les contrôler singulièrement

### 4.7.3 Fonctions utilisées dans le programme

### 4.7.4 Structogramme

### 4.7.5 Structogramme

## 4.8 Phase de production en série

### 4.8.1 Rédaction du protocole de mise en service de post-production

Etape | Quoi faire | Valeur attendue | Valeur mesurée | Erreur | Validée | Mes. Ref.
1 | Testez la continuité des GND | - | - | - | OK | -
2 | Implantez tous les composants SMD de la face BOTTOM | - | - | - | OK | -
3 | Vérifiez que le switch bloque la sortie du régulateur en vérifiant qu’il n’y ait pas de continuité entre TP7 et TP8 | Pas de beep | - | - | OK | -

### 4.8.2 Rédaction du mode d’emploi utilisateur

Le prototype à des contrôles très basique. Il faut prendre le PCB en mains de manière à avoir le port USB-C en haut à droite comme ça :

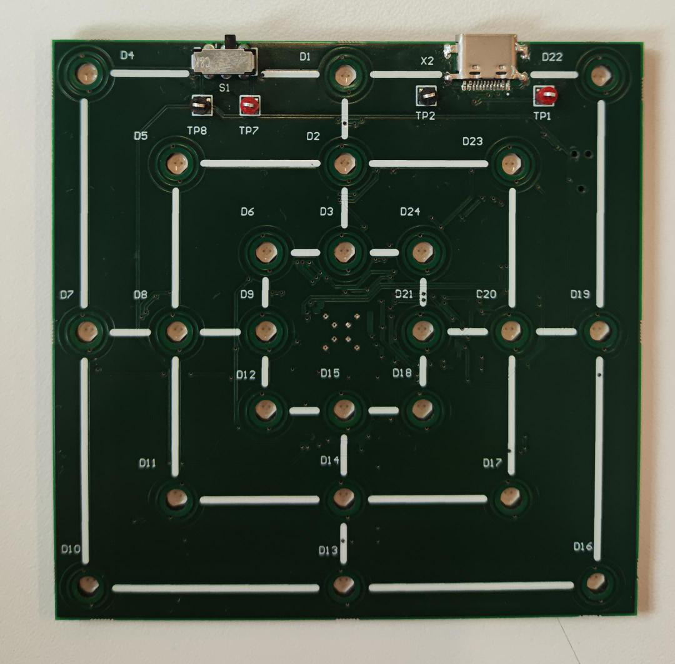
[picture p32: figure]

Après, il faut simplement vérifier que le switch soit dans la même position que dans l’image avant de la brancher par USB-C. Quand le circuit est branché, il faut actionner le switch pour qu’il soit dans l’autre position pour allumer le circuit.

Pour l’instant (04.06.2025) le code pour jouer au jeu du moulin avec les règles officielles n’est pas fonctionnel, mais les LEDs doivent changer de couleur et s’éteindre en cliquant sur la touche quand la LED est allumé en rouge (sauf les LEDs D4 jusqu’à D9).

## 4.9 Liste des outils utilisés et leur version

Altium v24.1.2

STM32cubeIDE v1.18.1

Draw.io

GitHub v3.16.3

# 5 Contrôle

## 5.1 Validation ERC

Après avoir fait valider mon schéma par le superviseur de mon projet M. Cunha Fabio, il restait quand même un warning. Ce warning est dû au fait que le régulateur K n’a pas de VCC en entré. On ne peut malheureusement pas mettre de VCC vers régulateur sinon on risque de compromettre le circuit entier. En effet, en mettant un VCC ici, le VCC du circuit sera fixé à 5V et le MCU ne peut pas supporter de telles tensions. Ce warning ne sera donc pas pris en compte.

## 5.2 Validation DRC

Le DRC était OK mais après avoir dû faire un changement express qui ne m’a pas permis de refaire un DRC, j’ai une erreur de routage. On a un îlot de GND coupé des plans donc un composant n’est pas relié au GND mais ce problème est remédiable à l’aide d’un fils. En changeant le type de plan d’haché à plein le problème est résolu. Le DRC est celui créé après les changements de PCB.

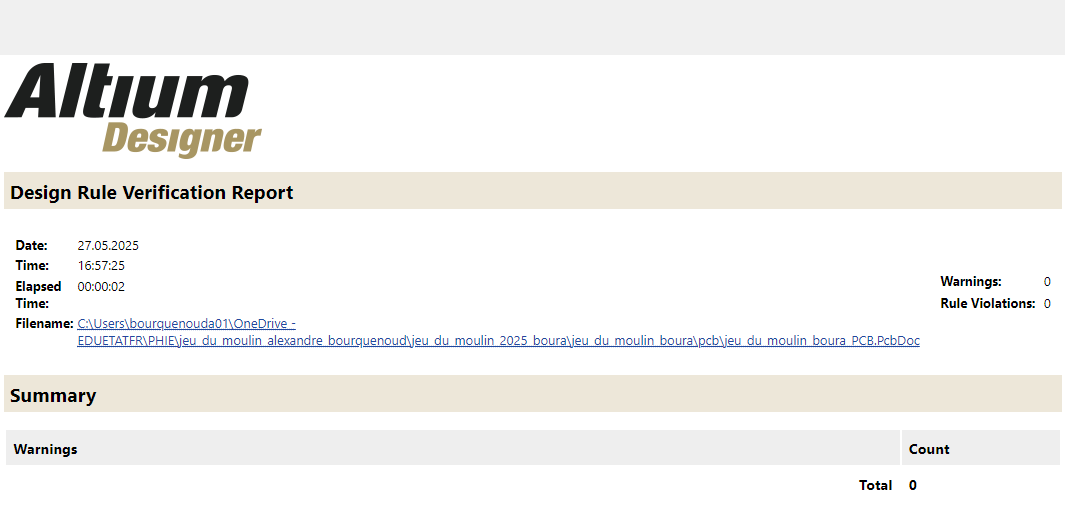
[picture p33: figure]

## 5.3 Validation Eurocircuits

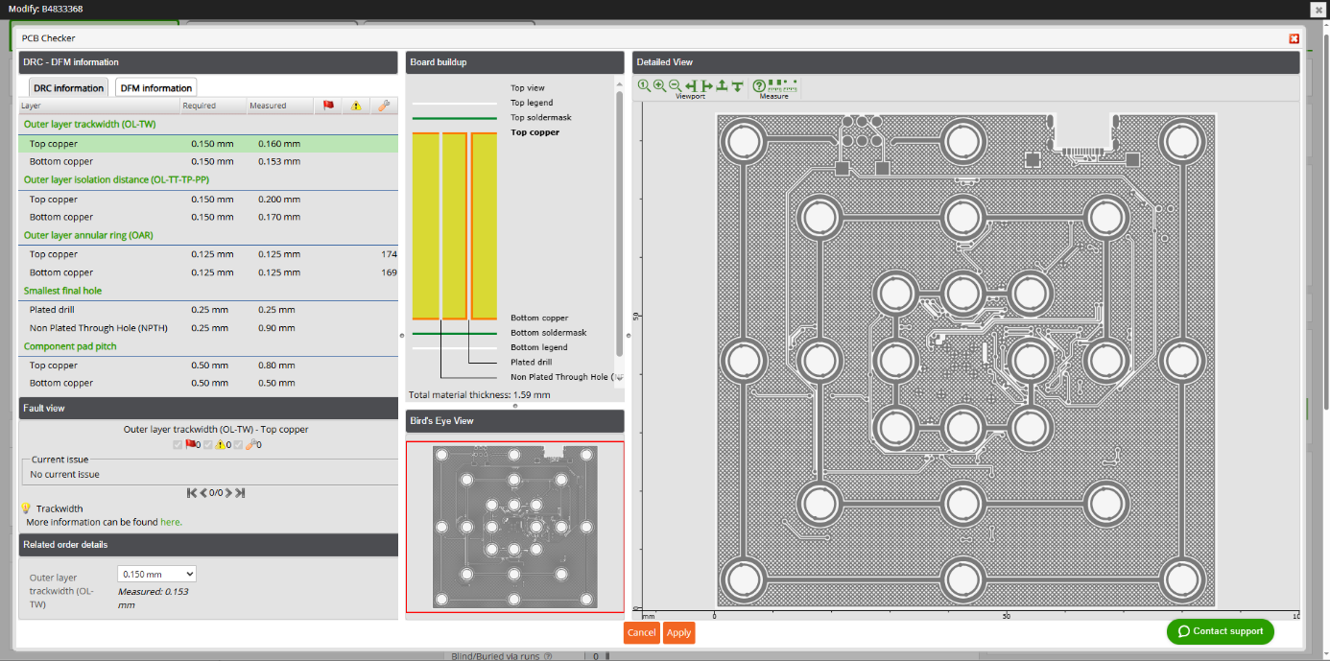
[picture p34: figure]

La validation faite sur Eurocircuit n’est pas la même que celle commandé car le plan haché a du être changer mais il n’y avait pas d’erreurs.s

## 5.4 Validation par la mise en service du prototype

Après avoir monté le circuit, quelques étapes critique de la mise en service ne pouvaient pas être accomplies correctement, notamment la partie touche capacitive avait de la peine à bien fonctionner. J’en conclus donc que le circuit n’est pas entièrement valide et devrais être retravailler afin d’accomplir le but du projet.

## 5.5 Problèmes rencontrées

### 5.5.1 PCB

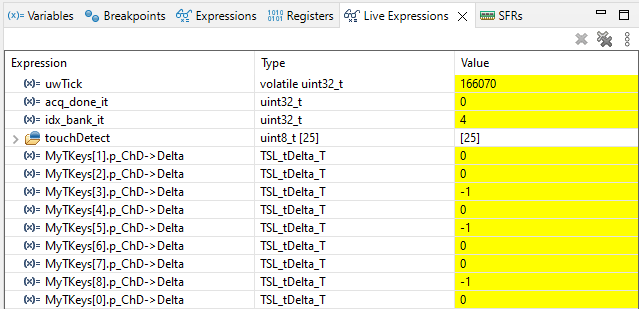
[picture p35: figure]

Dû au routage, les deltas utilisés pour la détection des touches sont trop bas pour avoir une détection précise. En Effet, quand on mesure les deltas via STM32CubeIDE, on peut voir que les deltas de lignes sont ok et ont des valeurs entre 200 et 500 quand une touche est pressée, mais les deltas de colonnes sont bien trop bas. Pour la colonne 1, on à des valeur max de -1 à -23 ; pour la colonne 2, on a des valeurs de -2 à -20 ; et pour la colonne 3, on a des valeurs de -2 à 6. Dans l’IDE, le delta minimum est limité à 35 donc c’est pratiquement impossible de détecter une pression correctement.

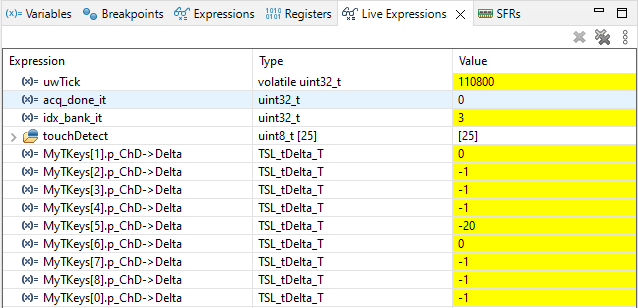
[picture p36: figure]

2 : Quand C1 n'est plus pressé

3 : Quand C1 est pressée

Pour remédier ce problème je pense qu’un routage en portant plus d’attention aux résistances des lignes et colonnes de la matrice serait mieux, ainsi qu’un PCB plus grand pour avoir plus d’espace pour les résistances en question.

### 5.5.2 FWR

Une ligne de LEDs ne s’allumais pas dû à un faux contacte de la résistance R26. Il fallait juste la rebraser correctement.

Le PCB ne connectait pas correctement au debugger avec la configuration de base. Il fallait changer le type en Hardware reset et la fréquence de Auto à 140 ou 1000. Il faut porter attention au fait que la résistance R2 est un résistance NMT donc non mounted et qui ne dois donc pas être montée.

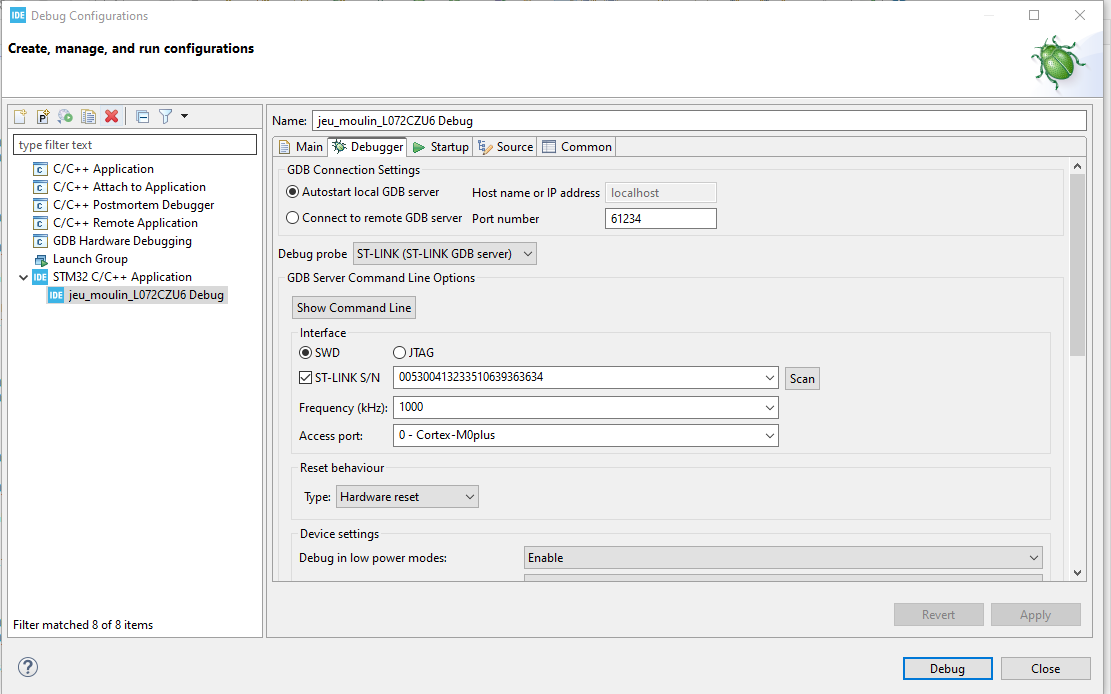
[picture p37: figure]

J’ai eu un problème de connexion de l’IDE au circuit. Quand on lance un débug avec les options de base, la connexion n’est pas effectuée. Pour remédier ce problème, il faut simplement changer le Reset behaviour pour avoir le type Hardware reset et la Frequency pour avoir 1000 ou 140(je n’ai pas tout testé mais Auto ne fonctionne pas) dans la Debug Configuration voici une photo de la fenêtre avec les paramètres correcte :

J’ai eu un grand problème de détection des touches. En effet, quand on lance le débug, le signal de détection sur les touches n’est lancé qu’un fois :

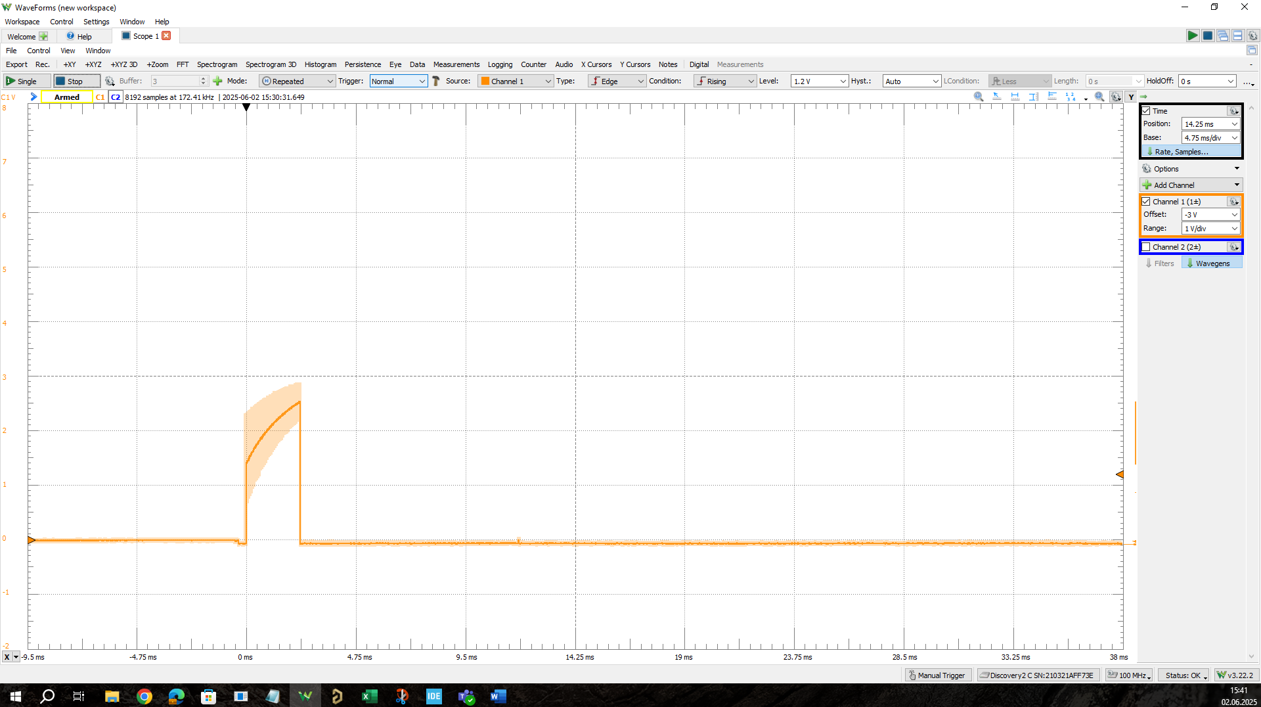
[picture p38: figure]

Ce qui nous empêche de détecter quoi que ce soit venant des touches. En faisant une investigation plus approfondie à l’aide de M.Egli, on a trouvé que le callback n’était pas appelé et que l’acquisition ne se terminait pas. Pour trouver ce qui causait le problème, M.Egli m’a proposé de diminuer le nombre de groupes de TSC et de les rajouter peu a peu pour voir quel groupe ne terminait pas son acquisition en observant les registres lié à l’acquisition (manuel de référence (https://eduetatfr-my.sharepoint.com/personal/alexandre_bourquenoud_studentfr_ch/Documents/PHIE/jeu_du_moulin_alexandre_bourquenoud/jeu_du_moulin_2025_boura/je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) p.387) :

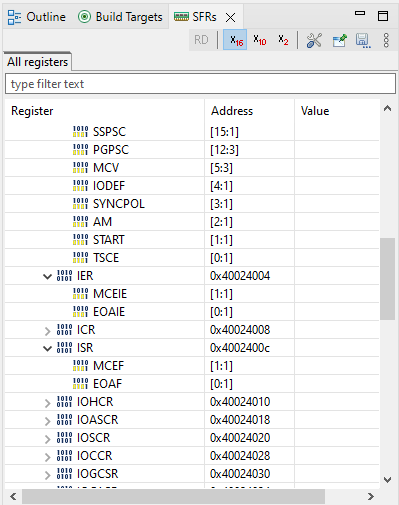
[picture p39: figure]

On a le bit EOAF qui signale la fin de l’acquisition. Il devrait être à "1" et on a aussi le MCEF qui signifie une erreur de compte maximum donc on est arrivé au compte max sans finir l’acquisition. Ce bit doit rester à "0" pour un fonctionnement correct. Après des tests, j’ai eu comme résultat :

Groupe 1 est OK

Groupe 2 est OK

Groupe 3 est OK

Groupe 4 est NOK -> PA9 est la pin de CS

En les mettant tous en même temps sauf le Groupe 4, on arrive à récupérer l’interruption, donc le bit EOAF monte à "1". Je vais donc essayer de trouver le problème avec le Groupe 4 en rebrasant le condensateur de sampling C11. Après plusieurs tests je me suis rendu compte qu’il doit y avoir un autre problème car Groupe 1 tout seul fonctionne, et quand on active le Groupe 4 en même temps que le Groupe 1 ça fonctionne, mais si on active tout les Groupes ensemble ça ne fonctionne pas et qu’en désactivant uniquement le Groupe 4 les 3 autres fonctionnent ?? Je suis donc aller chercher plus profondément en testant chaque IO du Groupe 4 et j’ai pu conclure que le problème venait de l’IO PA12 et PA11 donc sensor G4_IO3 et G4_IO4. Pour trouver le problème j’ai isolé chaque IO en activant tout les sensors dans le menu TSC mais en n’activant que 3 dans le middleware TOUCHSENSING et depuis cette fenêtre de paramètre :

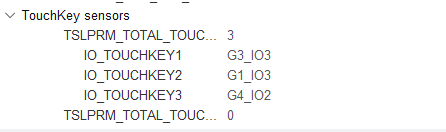
[picture p40: figure]

J’ai changé un à un les sensors jusqu’à trouver ceux qui posaient problème.

Après avoir vérifié au microscope pour voir s’il y avait des cours circuit et avoir rebraser les résistances R5 et R7 liées au pins PA11 et PA12 mais même après les changements, je ne peux pas les utiliser comme touches donc, je décide de monter une autre plaque et tester sur celle-ci si j’ai du temps. En cas de non-fonctionnement de l’autre plaque, je conclurai que le problème vient du PCB et du routage qui devra être changer à la création du prochain prototype.

# 6 Evaluation

## 6.1 Etat du projet

Le projet est terminé mais le prototype produit n’est pas bien fonctionnel, ce qui veut dire qu’il faudrait refaire une autre version en tenant compte des améliorations et problèmes rencontrées durant la création de cette première version. Le problème majeur à mon avis est le fonctionnement des touches qui pourrait être amélioré en changement le routage et layout du PCB. Les touches capacitives étant une partie principale du projet sont critique au fonctionnement correct, mais pour les faire fonctionner, j’ai dû employer une méthode firmware particulière qui ne suivait pas l’exemple de STMicroelectronics et qui utilise des valeurs et variables qui semble être attribué de manière arbitraire, non mesuré et propre au circuit. Je pense que dans des version future, on devrait être capable d’utiliser l’exemple fournie par STMicroelectronics directement sans faire recours à mes méthodes "bancal" grâce à un bon layout et routage.

## 6.2 Liste des modifications pour la prochaine version

Pour la prochaine version il faudra :

1 : Mettre le logo sur la face avant du prototype

2 : Annoter correctement la version du projet sur la sérigraphie arrière du PCB.

3 : Agrandir les PCB

4 : Refaire le layout en portant attention aux résistances de la matrice de touches

5 : Diviser la matrice comme l’exemple en annexe, ou trouver un moyen de raccourcir la longueur des pistes des colonnes.

6 : Revoir le firmware et essayer de diminuer le clignotement quand le nombre max de LEDs sont allumées.

7 : Créer le code pour le jeu.

## 6.3 Liste des délivrables

pcb | Schématique (.pdf)
| Fichier : | jeu_du_moulin_boura_SCH.pdf | Ici (https://eduetatfr-my.sharepoint.com/personal/alexandre_bourquenoud_studentfr_ch/Documents/PHIE/jeu_du_moulin_alexandre_bourquenoud/jeu_du_moulin_2025_boura/je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)
| Répertoire : | .\jeu_du_moulin_boura\pcb\pdf\
pcb | Plan d’implantation (.pdf)
| Fichier : | jeu_du_moulin_boura_EQU.pdf | Ici (https://eduetatfr-my.sharepoint.com/personal/alexandre_bourquenoud_studentfr_ch/Documents/PHIE/jeu_du_moulin_alexandre_bourquenoud/jeu_du_moulin_2025_boura/je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)
| Répertoire : | .\jeu_du_moulin_boura\pcb\pdf\
pcb | Gerber (.zip)
| Fichier : | jeu_du_moulin7.zip
| Répertoire : | .\jeu_du_moulin_boura\pcb\
fwr | Firmware (.project)
| Fichier : | là (https://eduetatfr-my.sharepoint.com/personal/alexandre_bourquenoud_studentfr_ch/Documents/PHIE/jeu_du_moulin_alexandre_bourquenoud/jeu_du_moulin_2025_boura/je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)
| Répertoire : | .\jeu_du_moulin_boura\fwr\jeu_moulin_L072CZU6
swr | Software (.exe)
| Fichier : | -
| Répertoire : | -
mec | Plan mécanique (.pdf)
| Fichier : | jeu_du_moulin_boura_MEC.pdf | Ici (https://eduetatfr-my.sharepoint.com/personal/alexandre_bourquenoud_studentfr_ch/Documents/PHIE/jeu_du_moulin_alexandre_bourquenoud/jeu_du_moulin_2025_boura/je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)
| Répertoire : | .\jeu_du_moulin_boura\pcb\pdf\
rpt | Liste de matériel (.pdf)
| Fichier : | jeu_du_moulin_boura_Project.pdf | Ici (https://eduetatfr-my.sharepoint.com/personal/alexandre_bourquenoud_studentfr_ch/Documents/PHIE/jeu_du_moulin_alexandre_bourquenoud/jeu_du_moulin_2025_boura/je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)
| Répertoire : | .\projectname\pcb\bom\

## 6.4 Amélioration possible

Sujet | Amélioration
PCB | En faisant la visite avec les Experts, ils ont mentionné le fait qu’il manquait une indication de version du projet sur la sérigraphie et le logo de l’EMF
PCB | Agrandissement du PCB pour avoir un meilleur layout surtout pour les résistances de la matrice de touches.
PCB | Suppression des pads de test pour les condensateurs de sampling car quand des fils y sont branché, les deltas de détection de pression des touches varient trop.
PCB | Changement du boitier du switch S1 en SMD ainsi que changement de type de connecteur USB-C pour les placer entièrement à l’arrière du PCB.
PCB | Ajout de trous de perçage dans les coins pour utiliser des entretoises qui permettrait de surélever le PCB pour qu’il soit à plat quand on le pose sur une table.
FWR | Changement du code des LEDs pour réduire le leak de courant sur les autres LEDs qui sont censés être éteintes.
PCB | Division de la matrice en 2 groupes de colonne. Exemple en annexe

## 6.5 Conclusion et avis personnel

En conclusion, Ce projet était destiné à créer un PCB permettant à l’utilisateur de jouer au jeu du moulin. Ce PCB a pour but de faire de la publicité pour la section électronique de l’EMF. Personnellement, j’ai trouvé que ce projet était intéressant à effectuer malgré le produit final qui n’est pas entièrement fonctionnel. Je pense néanmoins que cette idée de jeu du moulin basé sur les touches capacitives est réalisable et qu’avec le travail que moi-même et M.Egli avons mis dans ce projet nous sommes proches d’un PCB fonctionnel. En effet, en prenant compte les améliorations possibles et avec ma partie du code pour le contrôle des touches, même avec des valeurs de delta très basse, il serait possible de contrôler les touches avec une certaine précision. Si le problème de L2 et L3 est en effet hardware et vient du PCB, j’aurais tendance à croire que la prochaine version serra la bonne.

### 6.5.1 Signatures

Lieu : | EMF, 1705 Fribourg, Switzerland | _________________________
Date : | 04.06.2025 | Bourquenoud Alexandre

### 6.5.2 Sources

- https://www.fr.ch/emf
- Datasheet - STM32L072x8 STM32L072xB STM32L072xZ - Ultra-low-power 32-bit MCU Arm®-based Cortex®-M0+, up to 192KB Flash, 20KB SRAM, 6KB EEPROM, USB, ADC, DACs (https://www.st.com/resource/en/datasheet/stm32l072cz.pdf)
- Nos amis les MOSFET | Connect - Editions Diamond (https://connect.ed-diamond.com/Hackable/hk-012/nos-amis-les-mosfet)
- usb c - USB-C pulldown on the CC lines: Is one resistor enough? - Electrical Engineering Stack Exchange (https://electronics.stackexchange.com/questions/700576/usb-c-pulldown-on-the-cc-lines-is-one-resistor-enough)
- power - Current consumption estimation STM32L0 - Electrical Engineering Stack Exchange (https://electronics.stackexchange.com/questions/379660/current-consumption-estimation-stm32l0)
- Touch Sensing Software - User Guide (https://www.nxp.com/docs/en/user-guide/TSSUG.pdf)
- AND90146 - MOSFET Selection for Reverse Polarity Protection (https://www.onsemi.com/download/application-notes/pdf/and90146-d.pdf)
- Ultra-low-power STM32L0x2 advanced Arm®-based 32-bit MCUs - Reference manual (https://www.st.com/resource/en/reference_manual/rm0376-ultralowpower-stm32l0x2-advanced-armbased-32bit-mcus-stmicroelectronics.pdf)
- Ultra-low-power STM32L0x2 advanced Arm®-based 32-bit MCUs - Reference manual (https://www.st.com/resource/en/reference_manual/rm0376-ultralowpower-stm32l0x2-advanced-armbased-32bit-mcus-stmicroelectronics.pdf)

### 6.5.3 Version de ce document

version | date | qui | modification
V1.0.1 | 20250521 | bourquenouda | Premier PCB
V1.0.2 | 20250604 | bourquenouda | Doc et programmation

### 6.5.4 Annexes

#### 6.5.4.1 Schéma antécédant

Voici le schéma que j’ai utilisé comme appuie pour le projet :

#### 6.5.4.2 Exemple de la prochaine matrice de touche :

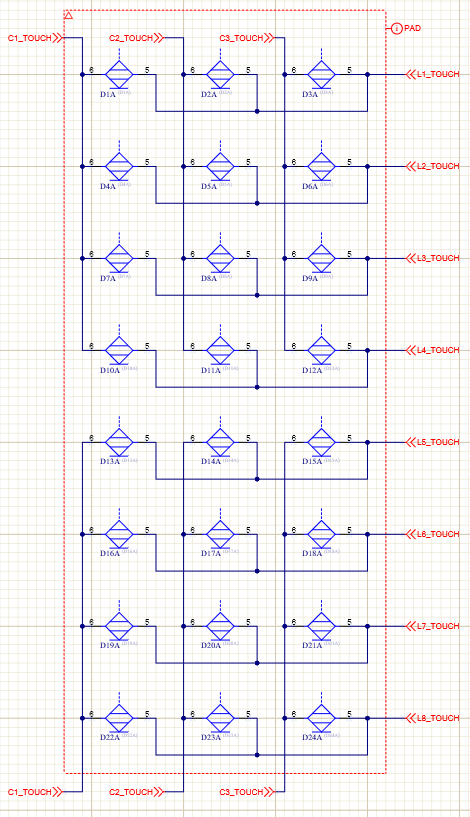
[picture p41: figure]

jeu-du-moulin-bourquenouda-rpt-development.docx 4 / 8

EMF: Projet Electronicien CFC Jeu du Moulin Bourquenoud
