boura01/jeu_du_moulin_2025_boura/jeu_du_moulin_boura/rpt/jeu-du-moulin-bourquenouda-rpt-presentation.pptx

## Image du projet Nom du projet TPI

EMF / Ecole des Métiers / Berufsfachschule – Fribourg
NOM et prénom de l'auteur
Candidat Electrocicien CFC
TPI 2020

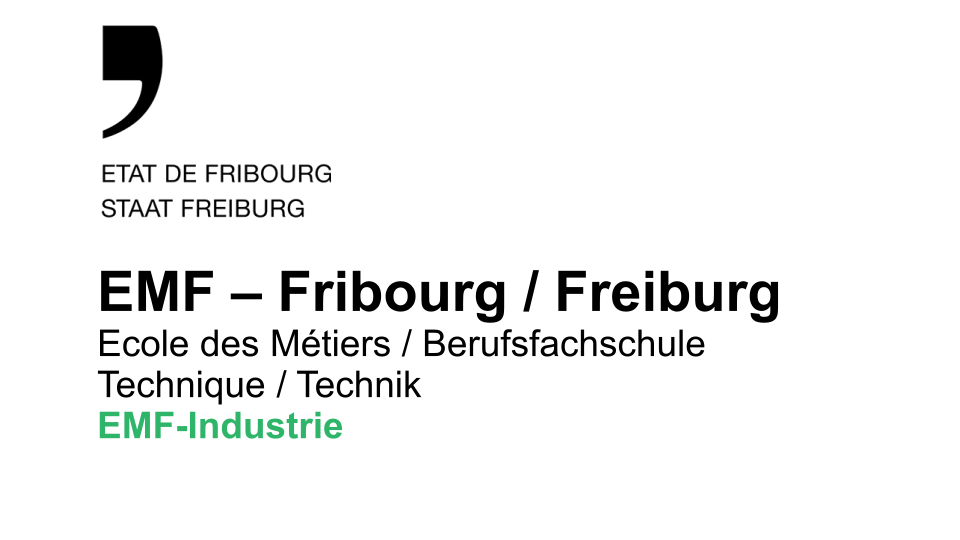
[picture p51: figure]

(A EFFACER --> SOIGNER L'ACCROCHE <--- A EFFACER)

## Déroulement de cette présentation

1. Information (de départ)
2. Plannification
3. Décision
4. Réalisation
5. Contrôle
6. Evaluation

EMF / NOM Prénom / Data <-- à modifier partout avec Insertion -> En-tête/Pied -> Pied de page

## 1. Information: Objectifs du projet

## 1. Information: Tâches à réaliser

## 2. Plannification: prévisionnelle

- Etude des composants : 4h (prévu 3h)
- Réalisation du schématique : 10h
- Réalisation du pcb: 10h
- Rédaction protocole de Mise en service: 4h
- Documentation : (20%) …

Tâches | pré | eff
1
2
3
4

## 2. Plannification: réelle

- Etude des composants : 4h (prévu 3h)
- Réalisation du schématique : 10h
- Réalisation du pcb: 10h
- Rédaction protocole de Mise en service: 4h
- Documentation : (20%) …

Tâches | pré | eff
1
2
3
4

## 3. Décision: les plus importantes

## 4. Réalisation: Schéma bloc

## 4. Réalisation: Schématique Globale

## 4. Réalisation: Estimation de la consommation

## 4. Réalisation: Régulateur de tension

## 4. Réalisation: LED témoin

## 5. Contrôle Validation ERC / DRC

- Validation ERC
- Validation DRC

## 5. Contrôle Validation Fab. + mise en service

- Validation Eurocircuit
- Validation par la mise en service

## 6. Evaluation: Etat du projet / modifications

## 6. Evaluation: délivrables

## 6. Evaluation: Liste des délivrables

## 6. Evaluation: Liste des outils utilisés (version)

## 6. Evaluation: Amélioration / Avis personnel

## Slide 20

Merci pour votre écoute
Avez-vous des questions … ?

Image du projet
Nom du projet TPI
