boura01/jeu_du_moulin_2025_boura/jeu_du_moulin_boura/rpt/ressource/jeu du moulin 2025 Planning.pdf

Projet : Jeu du Moulin 2025 | Année | 2025 | 2025 | 2025 | 2025 | 2025 | 2025 | 2025 | 2025 | 2025 | 2025 | 2025 | 2025 | 2025 | 2025 | 2025 | 2025 | 2025 | 2025 | 2025 | 2025 | 2025 | 2025 | 2025 | 2025 | 2025 | 2025 | 2025 | 2025 | 2025 | 2025 | 2025 | 2025 | 2025 | 2025 | 2025
Nombre Jour Travaillés | 17 | Mois Nb | 5
| | | 5 | 5 | 5 | 5 | 5 | 5 | 5 | 5 | 5 | 5 | 5 | 5 | 5 | 5 | 5 | 5 | 5 | 5 | 5 | 6 | 6 | 6 | 6 | 6 | 6 | 6 | 6 | 6 | 6 | 6 | 6 | 6 | 6 | 6
Mois Nom Mai | Mai | Mai | Mai | Mai | Mai | Mai | Mai | Mai | Mai | Mai | Mai | Mai | Mai | Mai | Juin | Juin | Juin | Juin | Juin | Juin | Juin | Juin | Juin | Juin | Juin | Juin | Juin | Juin | Juin | Juin | Juin | Juin | Juin | Juin
Durée du Projet sur Calendrier | 17 | Jour Nb | 12 | 13 | 14 | 15 | 16 | 17 | 18 | 19 | 20 | 21 | 22 | 23 | 24 | 25 | 26 | 27 | 28 | 29 | 30 | 31 | 1
2

3

4

5

6

7

8

9101112131415

Total d'heure | 118 | Jour Nom | lundi | mardi | mercredi | jeudi | vendredi | samedi | dimanche | lundi | mardi | mercredi | jeudi | vendredi | samedi | dimanche | lundi | mardi | mercredi | jeudi | vendredi | samedi | dimanche | lundi | mardi | mercredi | jeudi | vendredi | samedi | dimanche | lundi | mardi | mercredi | jeudi | vendredi | samedi | dimanche
Date | 12.05.2025 | 13.05.2025 | 14.05.2025 | 15.05.2025 | 16.05.2025 | 17.05.2025 | 18.05.2025 | 19.05.2025 | 20.05.2025 | 21.05.2025 | 22.05.2025 | 23.05.2025 | 24.05.2025 | 25.05.2025 | 26.05.2025 | 27.05.2025 | 28.05.2025 | 29.05.2025 | 30.05.2025 | 31.05.2025 | 01.06.2025 | 02.06.2025 | 03.06.2025 | 04.06.2025 | 05.06.2025 | 06.06.2025 | 07.06.2025 | 08.06.2025 | 09.06.2025 | 10.06.2025 | 11.06.2025 | 12.06.2025 | 13.06.2025 | 14.06.2025 | 15.06.2025
Tâche | Début | Fin | Durée (h) 7 14 21 28 35 | 42 | 49 | 56 | 63 | 70 | 77 | 84 | 90 | 97 | 104 | 111 | 118
1- Étude du cahier des charges et de la documentation
Analyse du cahier des charges et du schéma existant | 12.05.2025 | 12.05.2025 | 2
Recherche de solution et dimensionnement | 12.05.2025 | 12.05.2025 | 2
2 - Réalisation du schéma et circuit imprimé
Schéma du circuit électronique | 12.05.2025 | 15.05.2025 | 20
Réalisation du circuit imprimé sur Kicad + révision | 14.05.2025 | 23.05.2025 | 30
DEADLINE 1 : Envoi du schéma+PCB2 au sup. pro. pour validation | 23.05.2025 | 23.05.2025 | 0
3- Commande du matériel
Commande des PCBs suite à une révision du supérieur PRO | 23.05.2025 | 23.05.2025 | 1
Préparation de la liste du matériel à commander + commande | 23.05.2025 | 23.05.2025 | 2
4- Programmation basique pour tester le PCB
Détection des touches | 26.05.2025 | 26.05.2025 | 10
Allumer et changer les leds de couleur | 27.05.2025 | 27.05.2025 | 10
5- Montage du PCB
Montage du PCB + programmation du prototype + 1er essai | 28.05.2025 | 28.05.2025 | 8
6- Mesure et validation des fonctionnalités
Mesure des signaux, consommation et vérification du prototype | 30.05.2025 | 30.05.2025 | 6
Procédure de montage/mise en service | 02.06.2025 | 02.06.2025 | 4
8- Documentation et dossier technique
Dossier technique | 12.05.2025 | 04.06.2025 | 20
Journal de travail | 12.05.2025 | 04.06.2025 | 1
Finalisation et relecture du dossier technique | 04.06.2025 | 04.06.2025 | 2
9- Présentation du TPI et entretien professionnel
Préparation de votre présentation oral
Présentation du travail et entretien avec les experts
Visite Experts
1ère visite
Total | 118 | 1
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
### 0 Pentecôte

1h en moins
veille de fête | Ascension
