boura01/jeu_du_moulin_2025_boura/jeu_du_moulin_boura/readme.md

# PHIE template pour organisation des dossiers
 
 Ce repository représente l'organisation des dossiers pour un projet en électronique.
 Pour plus de détails voir le wiki https://github.com/emf-fribourg/documentation/wiki/Organisation-du-repository
