boura01/jeu_du_moulin_2025_boura/jeu_du_moulin_boura/fwr/readme.md

# Dossier "fwr"

 Contient toutes les informations nécessaires au développement du firmware du système à micro.
 Ce dossier est spécialement conçu pour contenir un projet MPLABX.
