boura01/jeu_du_moulin_2025_boura/jeu_du_moulin_boura/mec/readme.md

# Dossier "mec"

 Contient tous les développement nécessaire à la création de la mécanique du système.
