boura01/jeu_du_moulin_2025_boura/jeu_du_moulin_boura/rpt/readme.md

# Dossier "rpt"

 Contient le rapport technique ainsi que tous les renseigements que l'on a jugé utile de collecter pour le projet.

 - Correspondance
 - Article sur un sujet du projet
 - Exemples, images, photos
 - Datasheet et/ou raccourcis vers Datasheets
 - etc...
