boura01/jeu_du_moulin_2025_boura/jeu_du_moulin_boura/sim/readme.md

# Dossier "sim"

 Contient toutes les informations à de la simulation ou émulation du système à micro.
