boura01/jeu_du_moulin_2025_boura/jeu_du_moulin_boura/swr/readme.md

# Dossier "swr"

 Contient les fichiers en langage objet destiné au PC gérant le système à micro.
 Ce dossier est spécialement prévu pour contenir un projet Visual Studio.
