boura01/jeu_du_moulin_2025_boura/jeu_du_moulin_boura/rpt/correspondance/readme.md

# Dossier "correspondance"

 Contient toute la correspondance du projet, mails, message Teams ...
