boura01/jeu_du_moulin_2025_boura/jeu_du_moulin_boura/rpt/draw/readme.md

# Dossier "draw"

 Contient les dessins réalisés pour le projet.
 Note: Un fichier projectname-rpt-draw.drawio peut contenir tous les dessins vectoriels.
