boura01/jeu_du_moulin_2025_boura/jeu_du_moulin_boura/rpt/photo/readme.md

# Dossier "photo"

 Contient les fichiers de photos en .jpg, .png ou autres format.
 Ces photos ou images, peuvent être modifié avec Gimp.
