boura01/jeu_du_moulin_2025_boura/jeu_du_moulin_boura/rpt/ressource/readme.md

# Dossier "ressources"

 Contient des fichiers d'exemple externes, des articles externes, des 'how-to' externes sur le sujet du projet.
