boura01/jeu_du_moulin_2025_boura/jeu_du_moulin_boura/rpt/video/readme.md

# Dossier "video"

 Contient les fichiers de video en .vid, .mp3 ou autres format.
