boura01/jeu_du_moulin_2025_boura/jeu_du_moulin_boura/rpt/photo/mesure_detection_proto_egli.png

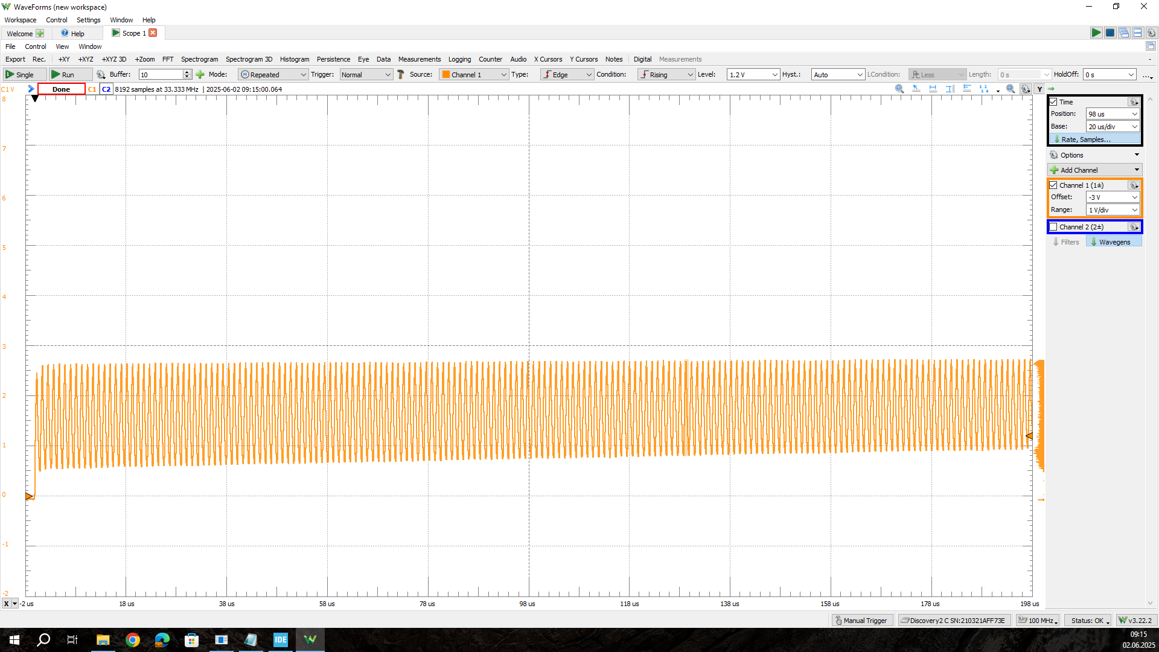
jeu_du_moulin_boura/rpt/photo/mesure_detection_proto_egli.png
