boura01/jeu_du_moulin_2025_boura/jeu_du_moulin_boura/pcb/bom/readme.md

# Dossier "bom"

 Contient le dernier fichier 'bill-of-material' généré.
