boura01/jeu_du_moulin_2025_boura/jeu_du_moulin_boura/rpt/order/readme.md

# Dossier "order"

 Contient les commandes de matériel pour le projet, y compris la commandes des PCB.
