boura01/jeu_du_moulin_2025_boura/jeu_du_moulin_boura/pcb/bom/jeu_du_moulin_boura_Project.pdf

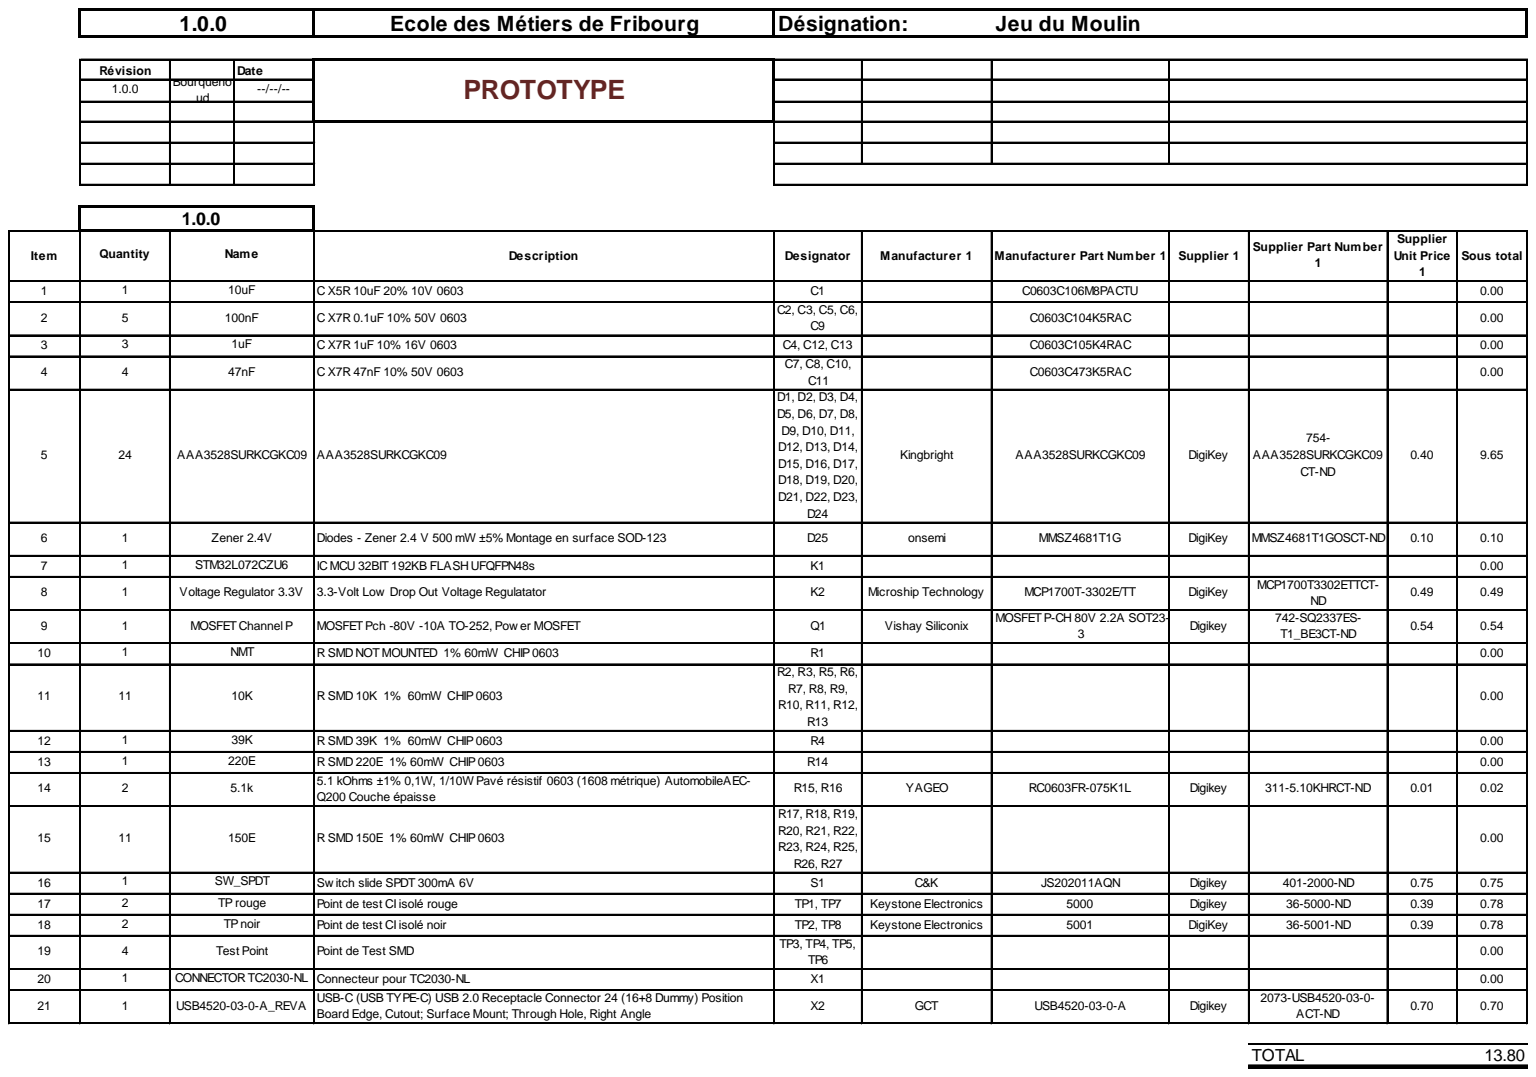
[picture p54: page 1]

Révision | | Date Bourqueno | PROTOTYPE
1.0.0 | ud | --/--/--

Item | Quantity | Name | Description | Designator | Manufacturer 1 | Manufacturer Part Number 1 | Supplier 1 | Supplier Part Number 1 | Supplier Unit Price 1 | Sous total

1 | 1 | 10uF | C X5R 10uF 20% 10V 0603 | C1 | | C0603C106M8PACTU | | | | 0.00
2 | 5 | 100nF | C X7R 0.1uF 10% 50V 0603 | C2, C3, C5, C6, C9 | | C0603C104K5RAC | | | | 0.00

3 | 3 | 1uF | C X7R 1uF 10% 16V 0603 | C4, C12, C13 | | C0603C105K4RAC | | | | 0.00
4 | 4 | 47nF | C X7R 47nF 10% 50V 0603 | C7, C8, C10, C11 | | C0603C473K5RAC | | | | 0.00

5 | 24 | AAA3528SURKCGKC09 | AAA3528SURKCGKC09 | D1, D2, D3, D4, D5, D6, D7, D8, D9, D10, D11, D12, D13, D14, D15, D16, D17, D18, D19, D20, D21, D22, D23, D24 | Kingbright | AAA3528SURKCGKC09 | DigiKey | 754-AAA3528SURKCGKC09 CT-ND | 0.40 | 9.65

6 | 1 | Zener 2.4V | Diodes - Zener 2.4 V 500 mW ±5% Montage en surface SOD-123 | D25 | onsemi | MMSZ4681T1G | DigiKey | MMSZ4681T1GOSCT-ND | 0.10 | 0.10

7 | 1 | STM32L072CZU6 | IC MCU 32BIT 192KB FLASH UFQFPN48s | K1 | | | | | | 0.00
8 | 1 | Voltage Regulator 3.3V | 3.3-Volt Low Drop Out Voltage Regulatator | K2 | Microship Technology | MCP1700T-3302E/TT | DigiKey | MCP1700T3302ETTCT-ND | 0.49 | 0.49

9 | 1 | MOSFET Channel P | MOSFET Pch -80V -10A TO-252, Pow er MOSFET | Q1 | Vishay Siliconix | MOSFET P-CH 80V 2.2A SOT23-3 | Digikey | 742-SQ2337ES-T1_BE3CT-ND | 0.54 | 0.54

10 | 1 | NMT | R SMD NOT MOUNTED 1% 60mW CHIP 0603 | R1 | | | | | | 0.00
11 | 11 | 10K | R SMD 10K 1% 60mW CHIP 0603 | R2, R3, R5, R6, R7, R8, R9, R10, R11, R12, R13 | | | | | | 0.00

12 | 1 | 39K | R SMD 39K 1% 60mW CHIP 0603 | R4 | | | | | | 0.00

13 | 1 | 220E | R SMD 220E 1% 60mW CHIP 0603 | R14 | | | | | | 0.00
14 | 2 | 5.1k | 5.1 kOhms ±1% 0,1W, 1/10W Pavé résistif 0603 (1608 métrique) AutomobileAEC-Q200 Couche épaisse | R15, R16 | YAGEO | RC0603FR-075K1L | Digikey | 311-5.10KHRCT-ND | 0.01 | 0.02

15 | 11 | 150E | R SMD 150E 1% 60mW CHIP 0603 | R17, R18, R19, R20, R21, R22, R23, R24, R25, R26, R27 | | | | | | 0.00

16 | 1 | SW_SPDT | Sw itch slide SPDT 300mA 6V | S1 | C&K | JS202011AQN | Digikey | 401-2000-ND | 0.75 | 0.75

17 | 2 | TP rouge | Point de test CI isolé rouge | TP1, TP7 | Keystone Electronics | 5000 | Digikey | 36-5000-ND | 0.39 | 0.78

18 | 2 | TP noir | Point de test CI isolé noir | TP2, TP8 | Keystone Electronics | 5001 | DigiKey | 36-5001-ND | 0.39 | 0.78
19 | 4 | Test Point | Point de Test SMD | TP3, TP4, TP5, TP6 | | | | | | 0.00

20 | 1 | CONNECTOR TC2030-NL | Connecteur pour TC2030-NL | X1 | | | | | | 0.00
21 | 1 | USB4520-03-0-A_REVA | USB-C (USB TYPE-C) USB 2.0 Receptacle Connector 24 (16+8 Dummy) Position Board Edge, Cutout; Surface Mount; Through Hole, Right Angle | X2 | GCT | USB4520-03-0-A | Digikey | 2073-USB4520-03-0-ACT-ND | 0.70 | 0.70
