boura01/jeu_du_moulin_2025_boura/jeu_du_moulin_boura/rpt/draw/logo/emf-logo-2018.dxf

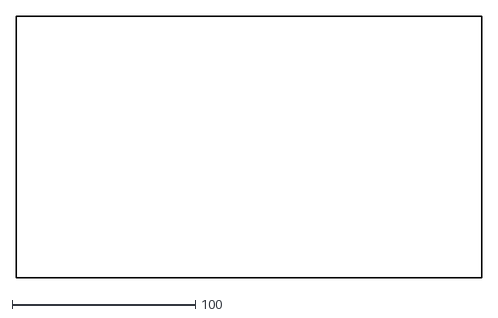
[picture p55: CAD file, 2025-05-12]
jeu_du_moulin_boura/rpt/draw/logo/emf-logo-2018.dxf
254.0 x 142.9
