boura01/jeu_du_moulin_2025_boura/jeu_du_moulin_boura/rpt/journal de travail/jeu_du_moulin_Boura_semaine_3.pdf

Journal de travail | Electronicien CFC | EMF-Industrie

### Bourquenoud Alexandre

Date | Projet | Thème | Action réalisée | Temps [H.h] | Report [H.h]
lundi | jeu-du-moulin-bourquenouda | RPT | rédaction du journal de travail. | 0.2
| jeu-du-moulin-bourquenouda | FWR | programmation sur STM32 pour allumer individuellement les LEDs. J'ai reussi a toutes les allumé sauf 2. Il faut maintenant que j'en allume plusieurs a la fois pour voir si il y a des interférence avec les touches | 6.6
| | | aide Mr.Pugin a réparer un bug | 0.2

26.05.2025 7.0
mardi | jeu-du-moulin-bourquenouda | RPT | rédaction du journal de travail. | 0.2
| | | aide Mr.Pugin a réparer un bug avec son projet | 0.5
| jeu-du-moulin-bourquenouda | FWR | J'ai avancer la programmation et j'arrive maintenant a les allumer individuellement. Il ne semblerait pas y avoir d'interférence avec les touches car je peux les allumer sans trop de latence (<0.4s) mais quand il y aura 18 LEDs allumer on pourra voir le clignotement, | 2.8
| jeu-du-moulin-bourquenouda | RPT | rédaction de la documentation | 1.0
| jeu-du-moulin-bourquenouda | FWR | Le programme pour changer allumer les LEDs est presque terminé. | 2.5

27.05.2025 7.0
mercredi | jeu-du-moulin-bourquenouda | RPT | rédaction du journal de travail. | 0.2
| jeu-du-moulin-bourquenouda | RPT | rédaction de la documentation | 1.0
| jeu-du-moulin-bourquenouda | FRW | J'ai continué d'avancer la programmation sur le prototype de M.Egli et le code fonctionne désormais comme demandé sur le cahier des charges donc j'ai pris du temps pour l'adapter au STM32 utiliser sur mon prototype. | 4.8

28.05.2025 6.0
Férié

29.05.2025
vendredi | jeu-du-moulin-bourquenouda | RPT | rédaction du journal de travail. | 0.2
| jeu-du-moulin-bourquenouda | RPT | Rédaction de la protocole de mise en service. | 1.5
| jeu-du-moulin-bourquenouda | RPT | rédaction de la documentation | 1.5
| jeu-du-moulin-bourquenouda | FWR | changements dans le programme pour convenir à l'IC utilisé sur mon proto | 1.5
| jeu-du-moulin-bourquenouda | PCB | Montage et début de la mise en service du PCB | 2.3

30.05.2025 7.0
Auto-évaluation personnelle hebdomadaire ↓↓↓ | 27.0
Cette semaine c'est aussi bien passé malgré le fait que j'ai commencé le montage plus tard que prévu à cause du jours férié…

jeudi
