boura01/jeu_du_moulin_2025_boura/jeu_du_moulin_boura/rpt/journal de travail/jeu_du_moulin_Boura_semaine_2.pdf

Journal de travail | Electronicien CFC | EMF-Industrie

### Bourquenoud Alexandre

Date | | Thème Projet | Action réalisée | Problème rencontré -> Décision | Temps [H.h] | Report [H.h]
| jeu-du-moulin-bourquenouda | RPT | rédaction du journal de travail. | | 0.2
| jeu-du-moulin-bourquenouda | PCB | fin de création de la BOM complète et commande des composants qui ne sont pas disponible à l'atelier | | 2.0
| jeu-du-moulin-bourquenouda | PCB | Changement "fondamental" du circuit. En effet, a cause d'un problème de compréhension, j'avais utiliser un plan de masse et un plan de VCC alors qu'il fallait plan de masse. Je dois donc changer le routage pour remédier a ce problème | Je n'ai pas pu ajouté le silkscreen au sommet des touches -> Je demanderai a M. Egli car il a des meilleur connaissances sur altium. | 3.8
| jeu-du-moulin-bourquenouda | RPT | rédaction de la documentation -> ajout des commentaire au sujet du placement des composants | | 1.0
19.05.2025 | Total du jour > | 7.0
jeu-du-moulin-bourquenouda | RPT | rédaction du journal de travail. | 0.2
jeu-du-moulin-bourquenouda | PCB | j'ai pu ajouter le soldermask au sommet des touches comme voulu grâce à l'aide de M. Egli. En effet, mon erreur était que je n'updatais pas correctement les empreinte. | 5.6
jeu-du-moulin-bourquenouda | RPT | rédaction de la doc | 1.0
jeu-du-moulin-bourquenouda | RPT | Discussion avec M.Egli au sujet du fonctionnement des touches capacitives et du risque que la matrice LED peut porter à la détection | 0.2
20.05.2025 | Total du jour > | 7.0
jeu-du-moulin-bourquenouda | RPT | rédaction du journal de travail.
0.2

lundi

mardi

jeu-du-moulin-bourquenouda | PCB | Changement du routage pour essaie de ne
| pas interférer avec le touches. J'avais déjà essayer de faire ça avant mais après une courte discussion avec M.Egli, je suis entrain de refaire le routage de tous les signaux de contrôle des LED pour qu'il ne passe pas en dessous des touches. J'ai aussi changé le symbole du MCU pour inclure le pad 49 qui est recommendé d'être braser au GND par le datasheet page 144 | | 1.0
jeu-du-moulin-bourquenouda | RPT | rédaction de la documentation -> ajout de simulation pour expliquer le RPP, explication des changements par rapport au schéma de M.Egli | | 3.0
jeu-du-moulin-bourquenouda | PCB | finission des dernier détails du pcb par example amélioration du routage des pistes et création des Gerber et vérification sur eurocircuit de la classe et validité du circuit. | | 2.8
21.05.2025 | Total du jour > | 7.0
jeu-du-moulin-bourquenouda | RPT | rédaction du journal de travail. | | 0.2
jeu-du-moulin-bourquenouda | PCB | création des Gerber et vérification sur eurocircuit de la classe et validité du circuit. | | 1.3
jeu-du-moulin-bourquenouda | FWR | Revue du programme crée par M.Egli et du mon ancien code pour matrice de LEDs pour voir si c'est possible de l'implementer sur le STM32 | | 1.0
jeu-du-moulin-bourquenouda | | Mise au point de la progression du projet avec M.Cunha et ensuite | | 0.5
jeu-du-moulin-bourquenouda | FWR | essaie debugger le programme de test de M.Egli pour comprendre le fonctionnement de STM32CubeIDE | Problème de connexion qui m'empèche de debugger sur la plaque fourni par M.Egli | 0.5
jeu-du-moulin-bourquenouda | FWR | programmation des touches et LED pour que ce soir conforme a ce qu'on me demande dans le cahier des charges | | 3.5

mercredi

jeudi

22.05.2025 | Total du jour > | 7.0
jeu-du-moulin-bourquenouda | RPT | rédaction du journal de travail. | | 0.2
jeu-du-moulin-bourquenouda | | Visite des experts et discussion au sujet de l'état actuel du projet et de si il est possible à terminer dans les temps | | 0.5
jeu-du-moulin-bourquenouda | FWR | création du code de contrôle des LEDs | Je viens de remarquer un problème fondamental qui rend le contrôle des LEDs de manière individuel… et oui, en effet le fait que les LEDs soit inversé fait que quoi qu'il se passe soit une ligne soit une colonne sera allumé -> trouver une LED bicolore avec les 2 LEDs pointant dans le même sens | 2.8
jeu-du-moulin-bourquenouda | FWR | création du code de contrôle des LEDs -> on peu desormais contrôler toutes les | Ce n'est pas exactement un problème car on peut changer les mode des I/O pour empêcher les LEDs de s'allumer quand il ne faut pas | 2.0
jeu-du-moulin-bourquenouda | RPT | Rédaction de la doc avec comme sujet la programmation et certaines impasses que j'ai rencontré et surmonté | | 1.0
jeu-du-moulin-bourquenouda | PCB | J'ai eu un problème(j'ai oulié de générer le stencil pour la face bottom) sur ma commande de PCB donc M.Egli est venu pour faire une commande de stencil correcte. | | 0.5
23.05.2025 | Total du jour > | 7.0
Total de la semaine > | 35.0
J'éstime avoir bien avancer aussi cette semaine, mais j'aurais voulu pouvoir commander le PCB un peu plus rapidement que comme prévu sur le planning. Pour la partie programmation, j'ai eu deux petites accroche que j'ai pu surmonter, et j'ai maintenant les bases nécessaires pour bien continuer la programmation. J'éspère que la semaine prochaine se déroulera tout aussi bien

vendredi

Auto-évaluation personnelle hebdomadaire ↓↓↓
