boura01/jeu_du_moulin_2025_boura/jeu_du_moulin_boura/rpt/photo/mesure_detection_mon_proto_que_debug.png

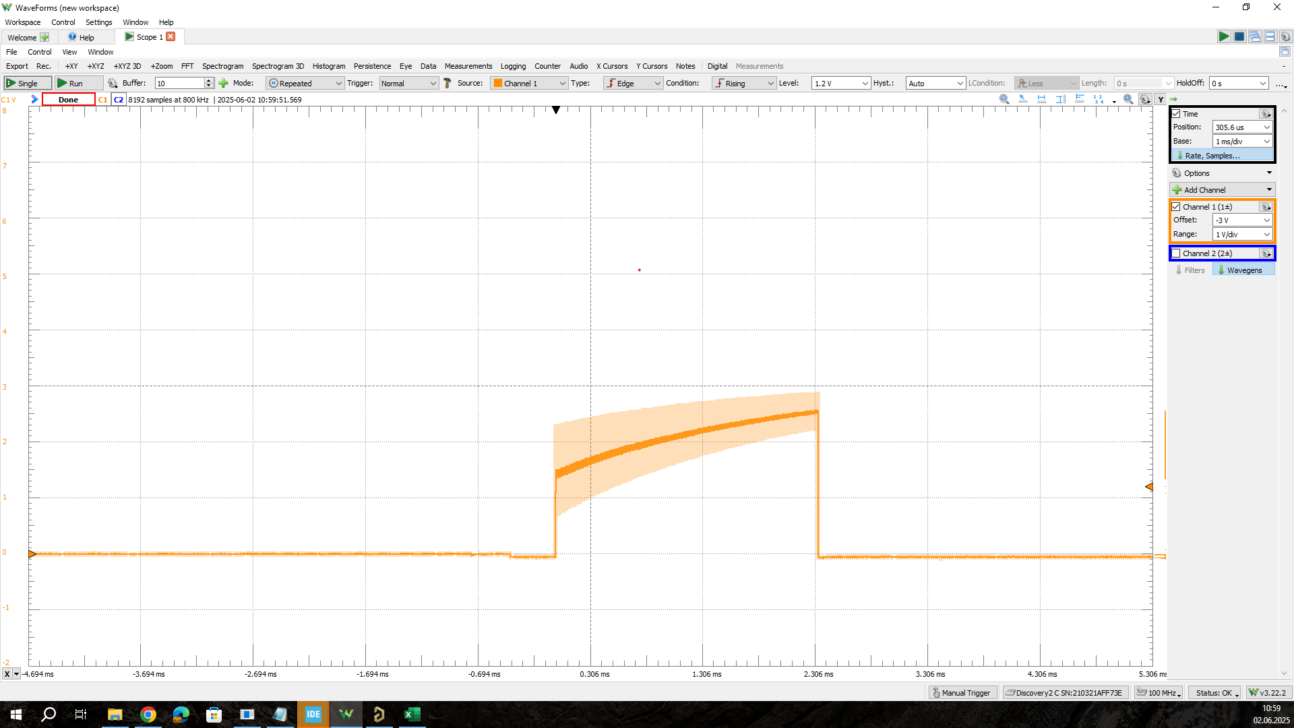
jeu_du_moulin_boura/rpt/photo/mesure_detection_mon_proto_que_debug.png
