boura01/jeu_du_moulin_2025_boura/jeu_du_moulin_boura/pcb/pdf/jeu_du_moulin_boura_SCH.pdf

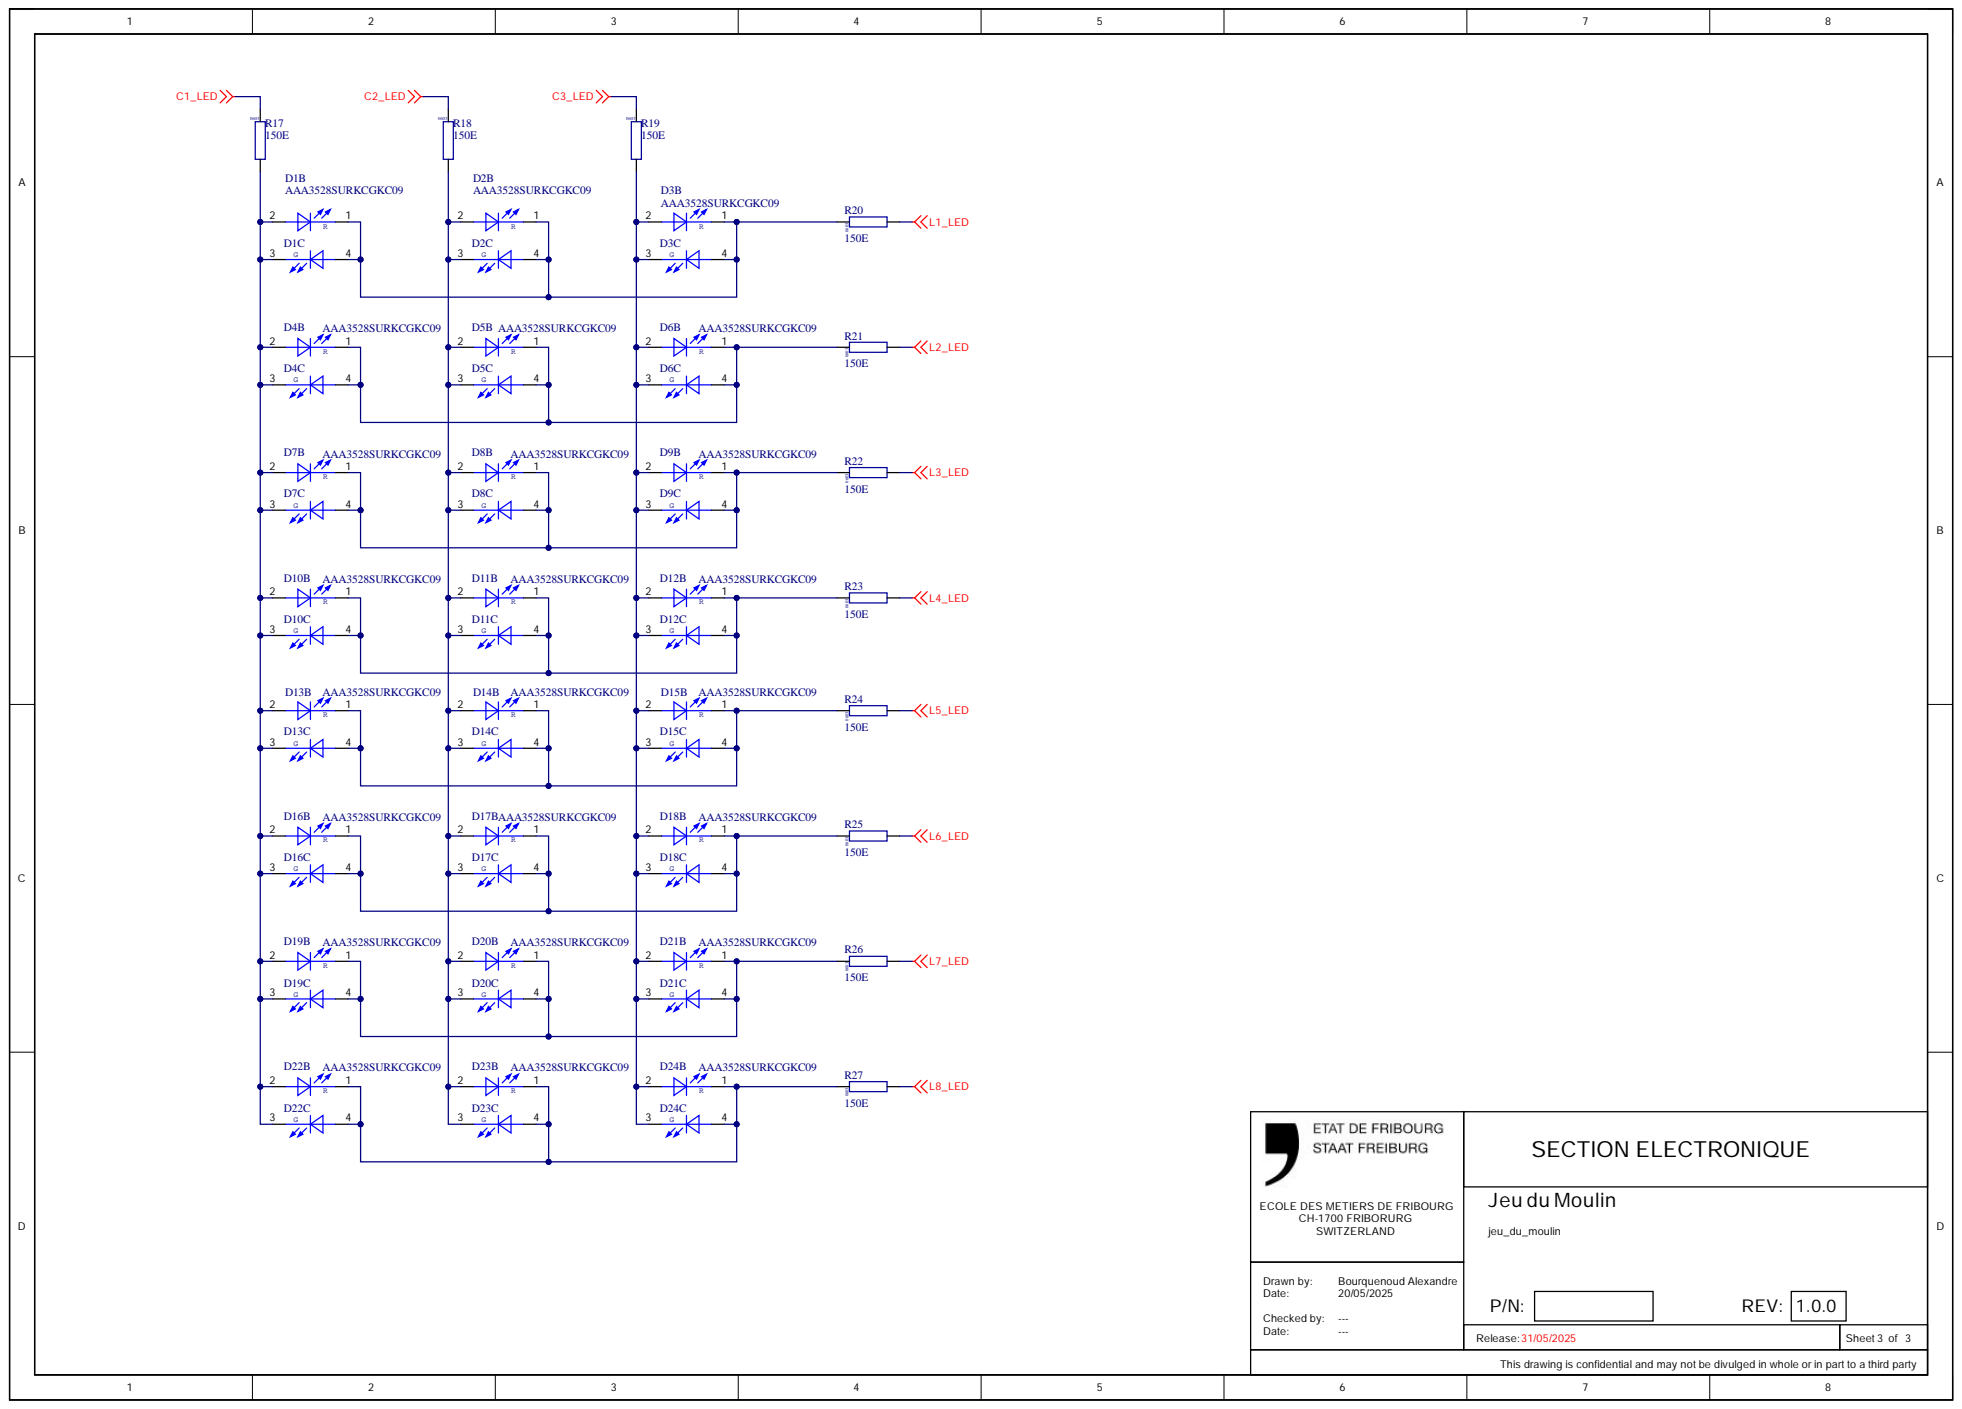
[picture p57: page 1]

ECOLE DES METIERS DE FRIBOURG

This drawing is confidential and may not be divulged in whole or in part to a third party

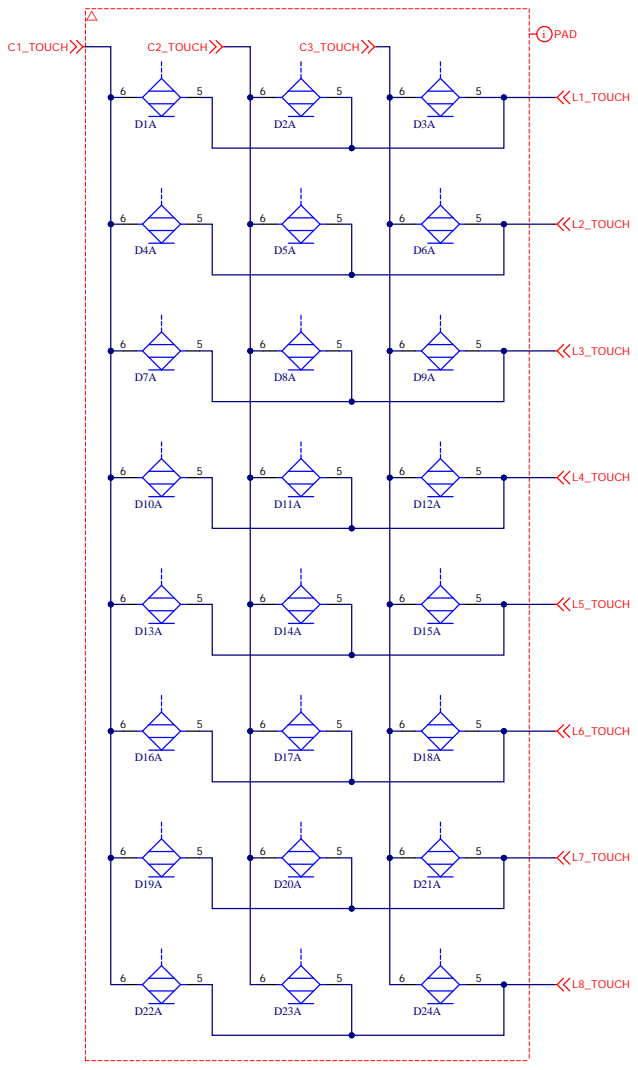
[picture p58: page 2]

ECOLE DES METIERS DE FRIBOURG

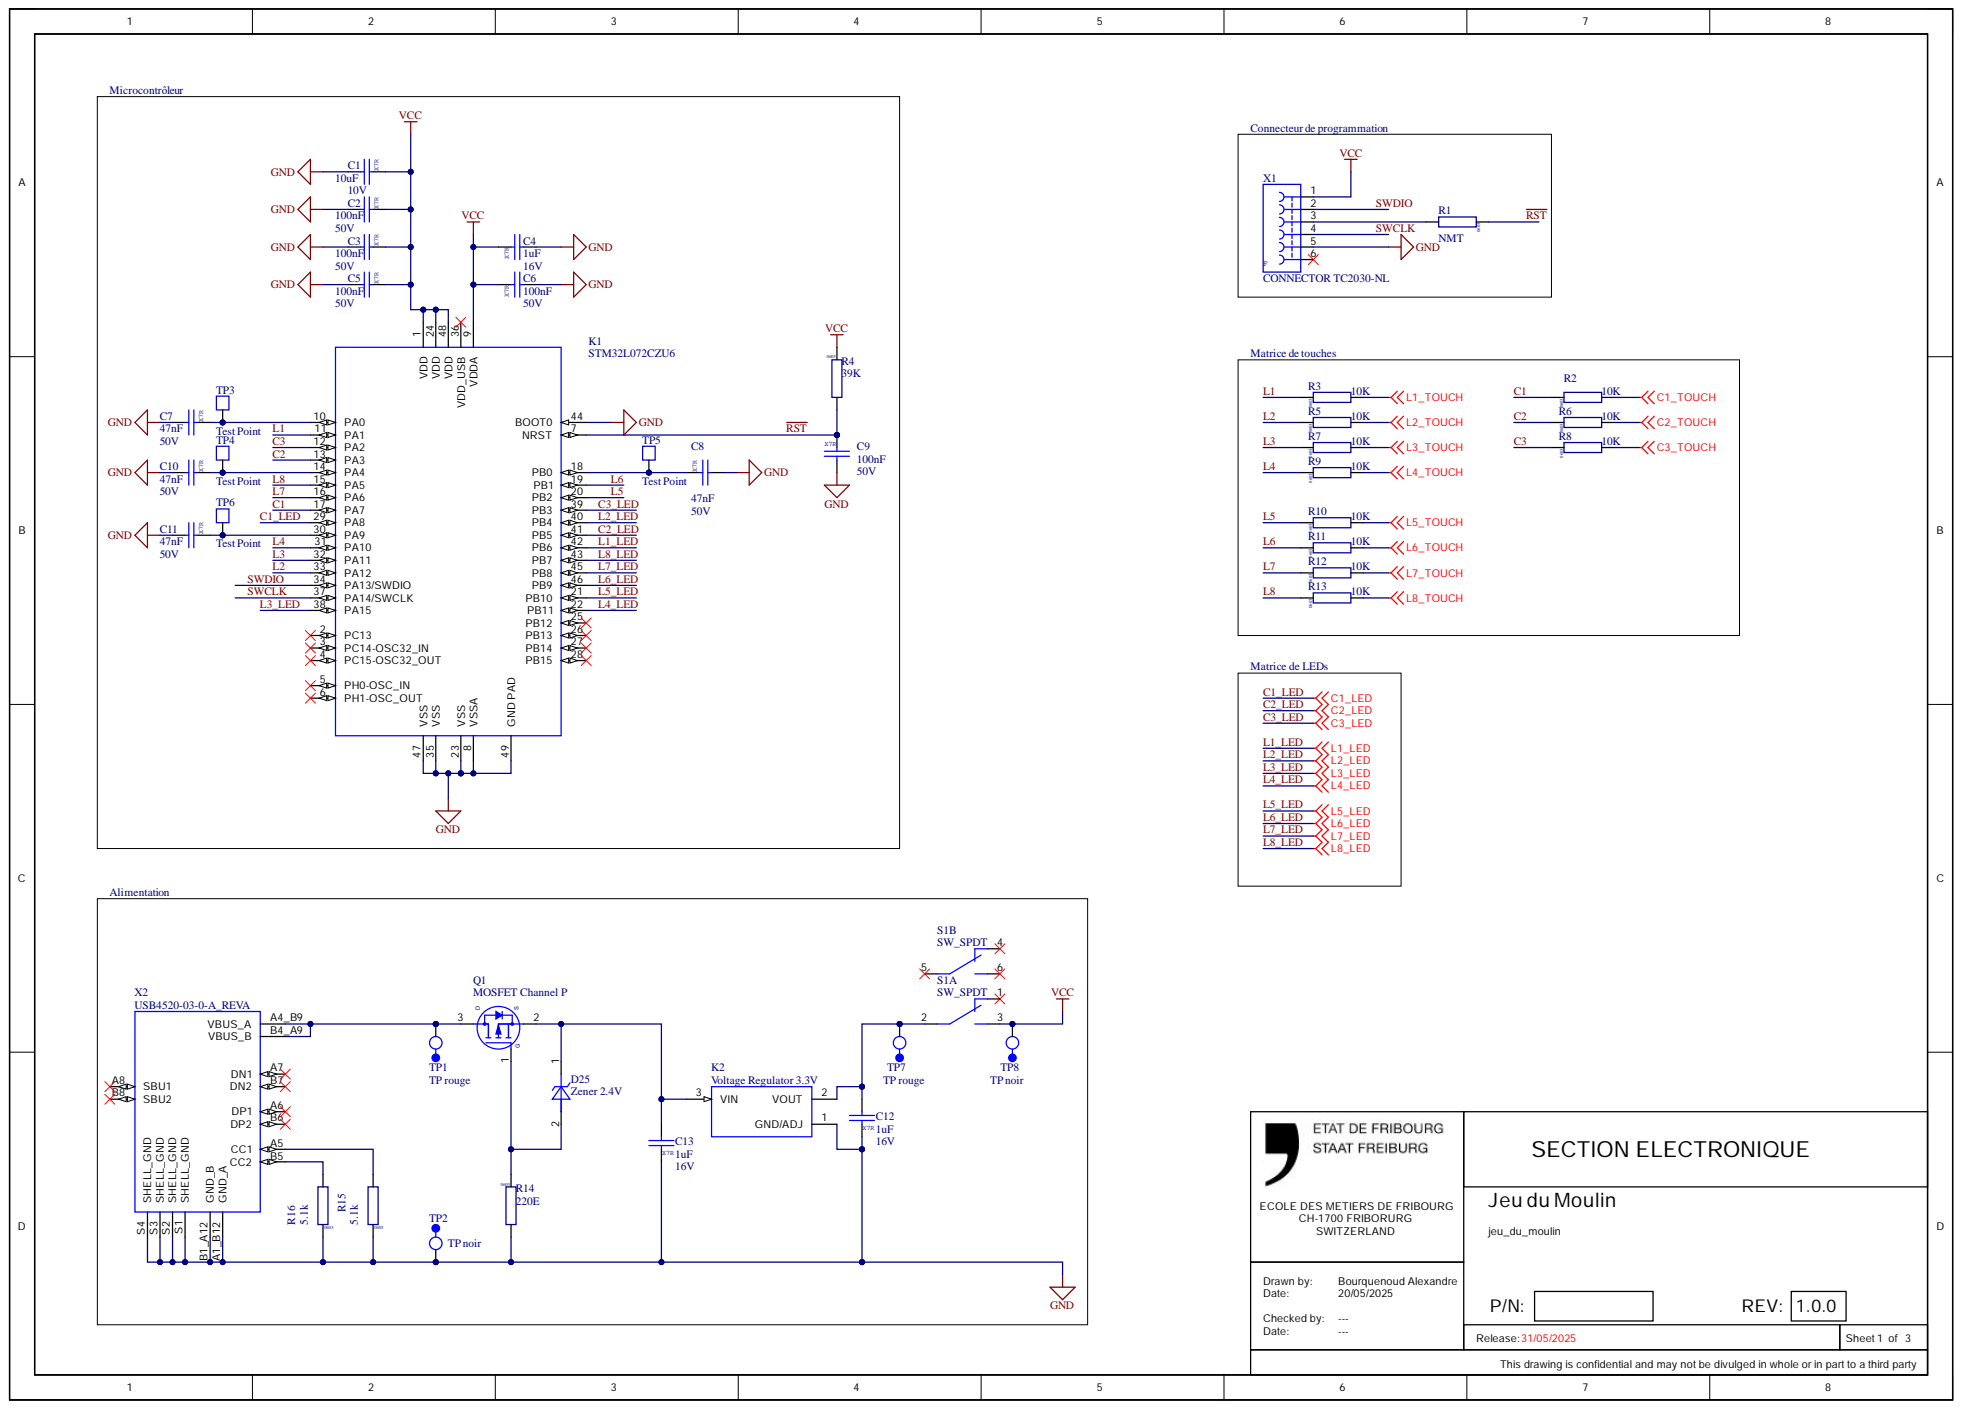
[picture p59: page 3]

ECOLE DES METIERS DE FRIBOURG

Line# | Name | Description | Designator | Quantity | Manufacturer 1 | Manufacturer Part Number 1 | Manufacturer Lifecycle1 | Supplier 1 | Supplier Part Number 1 | Supplier Unit Price1 | Supplier Subtotal 1
| 10uF | CX5R10uF20%10V0603 | C1 | 1 | | C0603C106M8PACTU
| 100nF | CX7R0.1uF10%50V0603 | C2, C3, C5, C6, C9 | 5 | | C0603C104K5RAC
3 | 1uF | CX7R1uF10%16V0603 | C4, C12, C13 | 3 | | C0603C105K4RAC
4 | 47nF | CX7R47nF10%50V0603 | C7, C8, C10, C11 | 4 | | C0603C473K5RAC
| AAA3528SURKCGKC09 | AAA3528SURKCGKC09 | D1, D2, D3, D4, D5, D6, D7, D8, D9, D10, D11, D12, D13, D14, D15, D16, D17, D18, D19, D20, D21, D22, D23, D24 | 24 Kingbright | | AAA3528SURKCGKC09 | Manual Solution | DigiKey | 754-AAA3528SURKCGKC09CT-ND | 0.402 | 9.65
| Zener 2.4V | Diodes - Zener 2.4V500mW±5%Montageen surfaceSOD-123 | D25 | 1 onsemi | | MMSZ4681T1G | Manual Solution | DigiKey | MMSZ4681T1GOSCT-ND | 0.09546 | 0.09546
| STM32L072CZU6 | ICMCU32BIT192KBFLASHUFQFPN48s | K1 | 1
8 | VoltageRegulator 3.3V | 3.3-Volt Low Drop Out VoltageRegulatator | K2 | 1 Microship Technology | | MCP1700T-3302E/TT | Manual Solution | DigiKey | MCP1700T3302ETTCT-ND | 0.48924 | 0.48924
| MOSFETChannel P | MOSFETPch -80V-10ATO-252, Power MOSFET | Q1 | 1 VishaySiliconix | | MOSFETP-CH80V2.2ASOT23-3 | Manual Solution | Digikey | 742-SQ2337ES-T1_BE3CT-ND | 0.54 | 0.54
10 | NMT | RSMDNOTMOUNTED 1%60mW CHIP0603 | R1 | 1
11 | 10K | RSMD10K 1% 60mW CHIP0603 | R2, R3, R5, R6, R7, R8, R9, R10, R11, R12, R13 | 11
9 | 39K | RSMD39K 1% 60mW CHIP0603 | R4 | 1
| 220E | RSMD220E 1%60mW CHIP0603 | R14 | 1
| 5.1k | 5.1kOhms ±1%0,1W, 1/10WPavérésistif 0603(1608métrique) AutomobileAEC-Q200Coucheépaisse | R15, R16 | 2 YAGEO | | RC0603FR-075K1L | Manual Solution | Digikey | 311-5.10KHRCT-ND | 0.009 | 0.09
12 | 150E | RSMD150E 1%60mW CHIP0603 | R17, R18, R19, R20, R21, R22, R23, R24, R25, R26, R27 | 11
13 | SW_SPDT | Switch slideSPDT300mA6V | S1 | 1 C&K | | JS202011AQN | Manual Solution | Digikey | 401-2000-ND | 0.75 | 0.75
| TProuge | Point detest CI isolérouge | TP1, TP7 | 2 KeystoneElectronics | | 5000 | Manual Solution | Digikey | 36-5000-ND | 0.39 | 0.78
| TPnoir | Point detest CI isolénoir | TP2, TP8 | 2 KeystoneElectronics | | 5001 | Manual Solution | DigiKey | 36-5001-ND | 0.39 | 0.78
| Test Point | Point deTest SMD | TP3, TP4, TP5, TP6 | 4
16 | CONNECTORTC2030-NL | Connecteur pour TC2030-NL | X1 | 1
17 | USB4520-03-0-A_REVA | USB-C(USBTYPE-C) USB2.0ReceptacleConnector 24(16+8Dummy) Position Board Edge, Cutout; SurfaceMount; Through Hole, Right Angle | X2 | 1 GCT | | USB4520-03-0-A | Manual Solution | Digikey | 2073-USB4520-03-0-ACT-ND | 0.7 | 0.7
