boura01/jeu_du_moulin_2025_boura/jeu_du_moulin_boura/pcb/pdf/jeu_du_moulin_boura_MEC.pdf

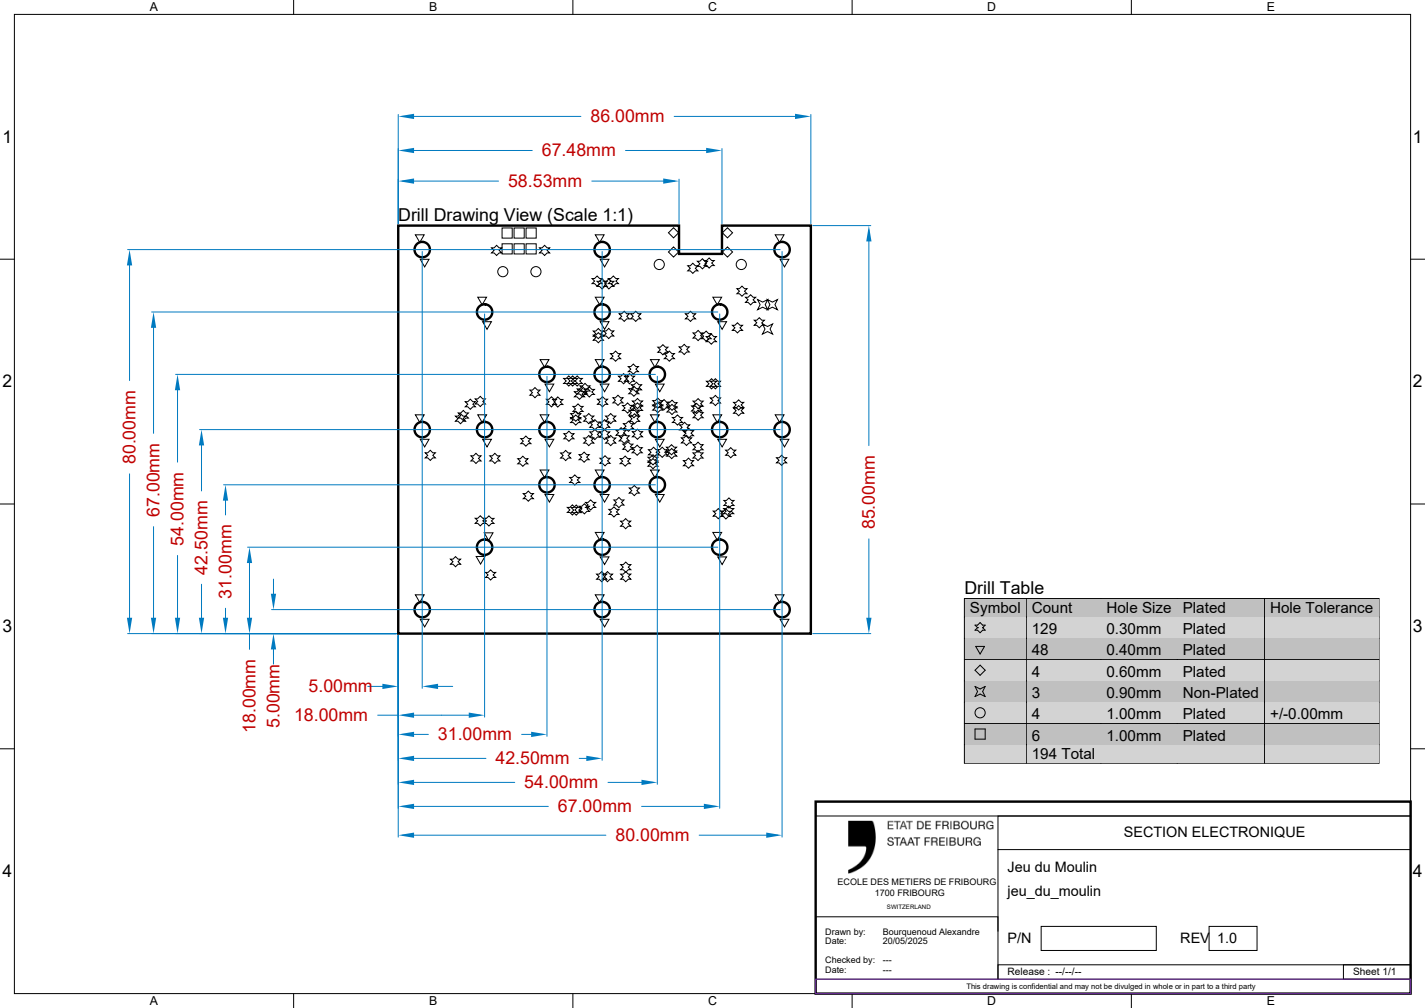
[picture p60: page 1]
Drill Table; Sheet 1/1; Date:; Drawn by:; REV; Bourquenoud Alexandre; Release : --/--/--; Checked by:; SECTION ELECTRONIQUE; 1700 FRIBOURG; SWITZERLAND

Drill Drawing View (Scale 1:1)

Symbol | Count | Hole Size | Plated | Hole Tolerance

129 | 0.30mm | Plated
48 | 0.40mm | Plated
4 | 0.60mm | Plated
3 | 0.90mm | Non-Plated
4 | 1.00mm | Plated | +/-0.00mm
6 | 1.00mm | Plated
194 Total

Jeu du Moulin
jeu_du_moulin

ECOLE DES METIERS DE FRIBOURG

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
