boura01/jeu_du_moulin_2025_boura/jeu_du_moulin_boura/pcb/pdf/jeu_du_moulin_boura_EQU.pdf

A

B

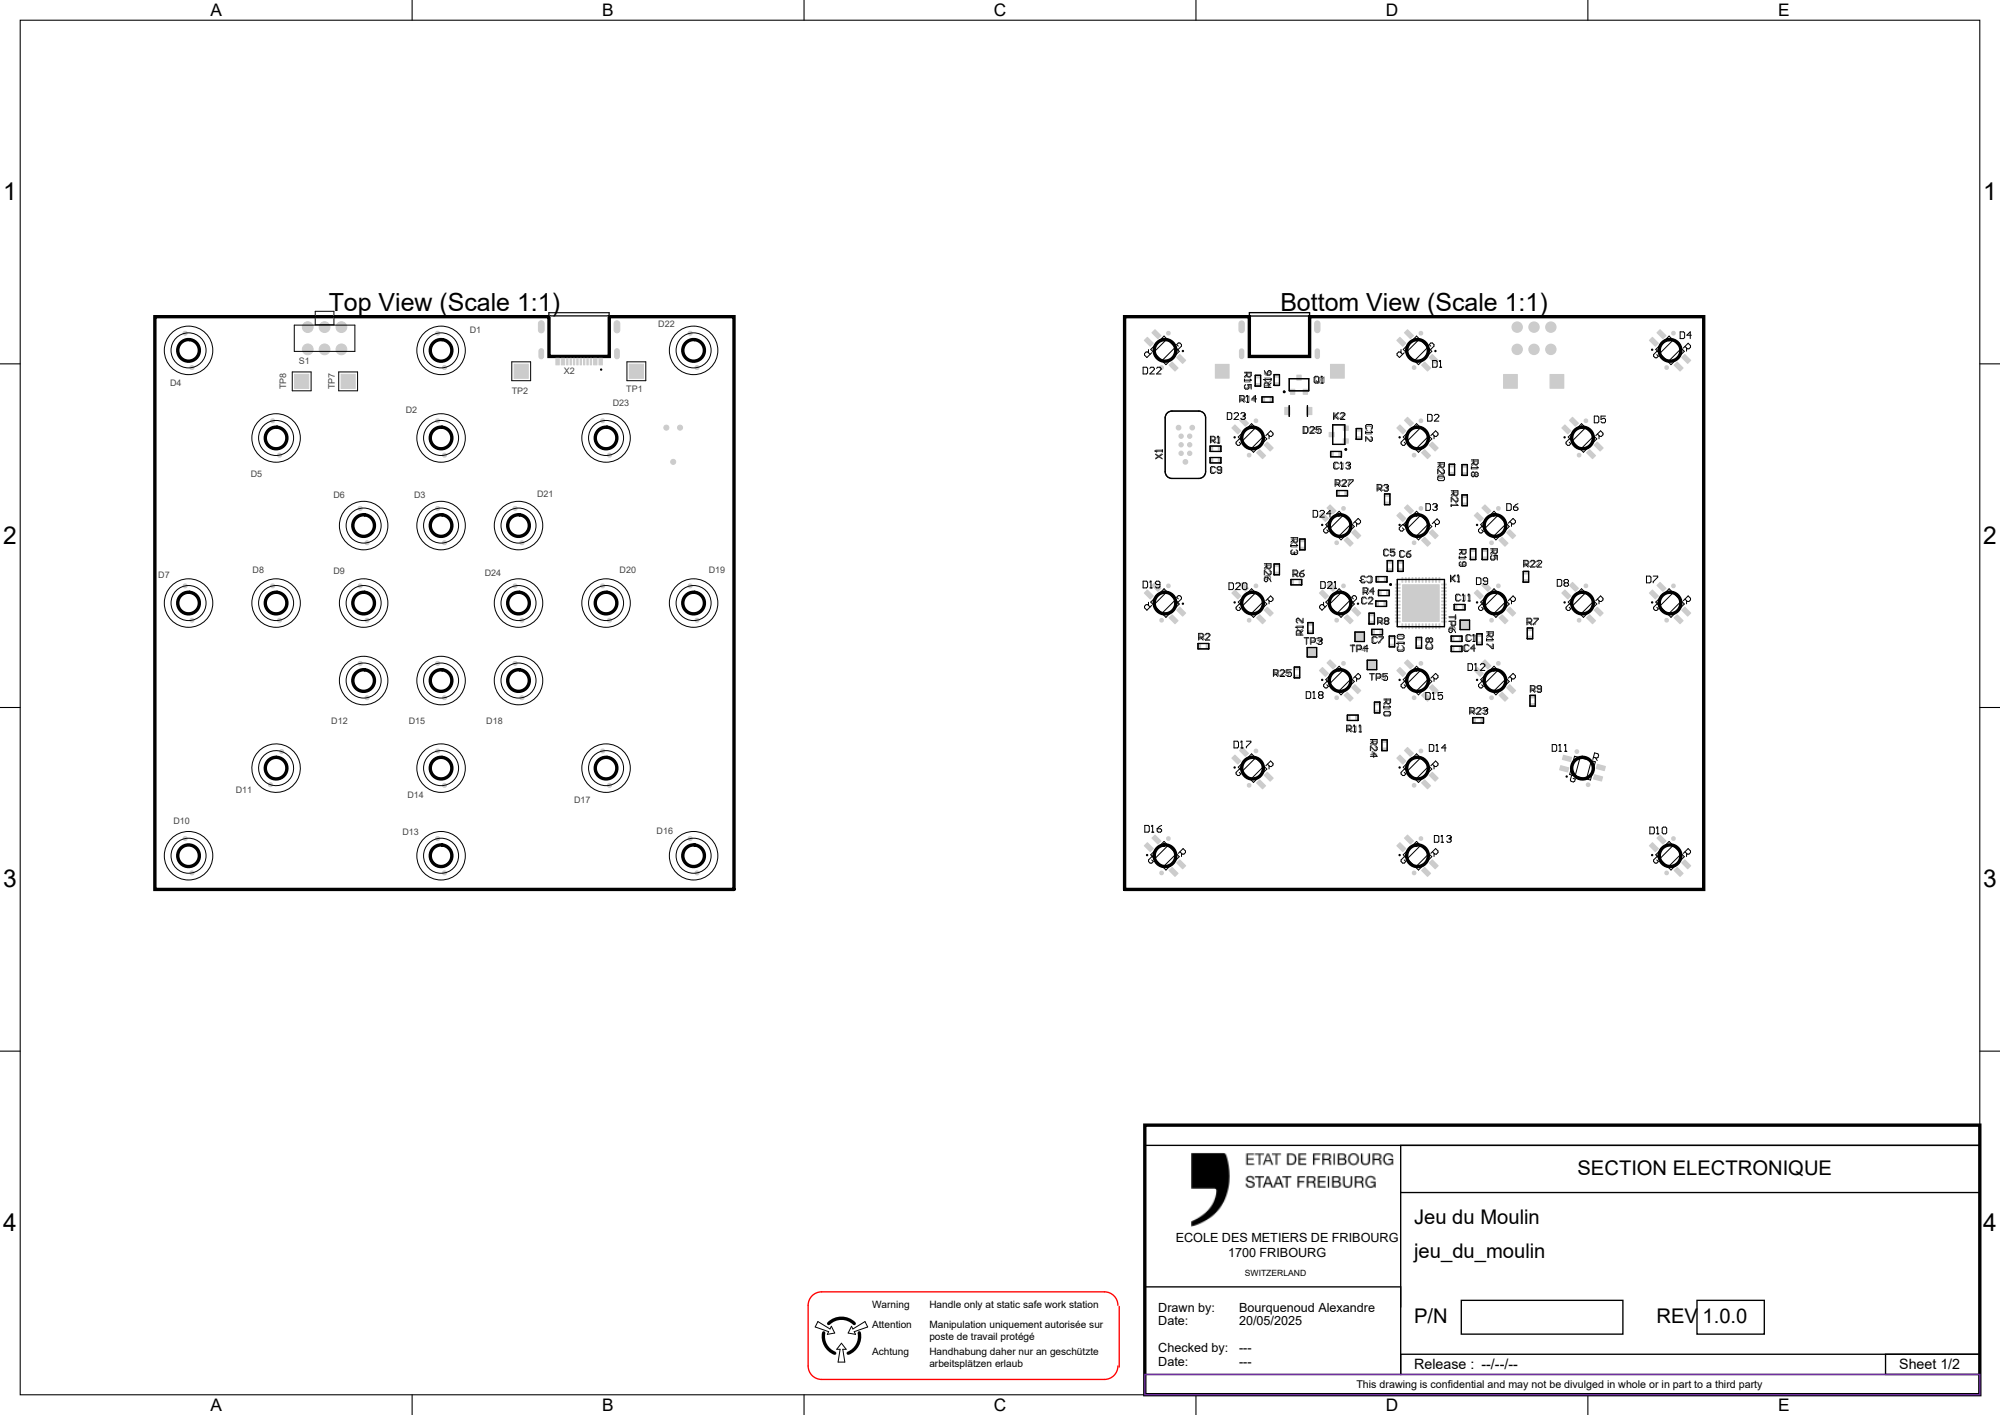
[picture p61: page 1]

ECOLE DES METIERS DE FRIBOURG

Manipulation uniquement autorisée sur
poste de travail protégé
Handhabung daher nur an geschützte
arbeitsplätzen erlaub

This drawing is confidential and may not be divulged in whole or in part to a third party

A

B

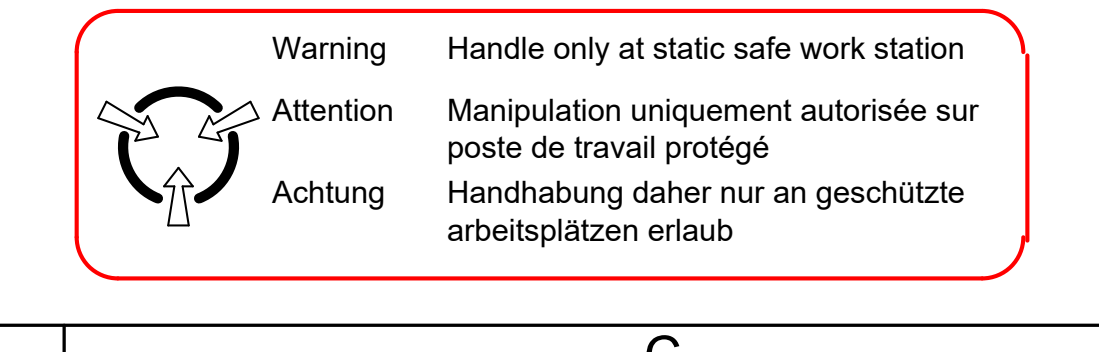
[picture p62: page 2]
Warning; Handle only at static safe work station; Attention; Achtung; Sheet 2/2; Date:; Drawn by:; =PCBCDrawnDate; REV; Bourquenoud Alexandre; Release : --/--/--; Checked by:; SECTION ELECTRONIQUE; 1700 FRIBOURG; SWITZERLAND

Jeu du Moulin
jeu_du_moulin

ECOLE DES METIERS DE FRIBOURG

Manipulation uniquement autorisée sur
poste de travail protégé
Handhabung daher nur an geschützte
arbeitsplätzen erlaub

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
