boura01/jeu_du_moulin_2025_boura/(list of files, drawings)

Other design files:
jeu_du_moulin_boura/pcb/jeu_du_moulin_boura_LedMatrix_SCH.SchDoc
jeu_du_moulin_boura/pcb/jeu_du_moulin_boura_PCB.PcbDoc
jeu_du_moulin_boura/pcb/jeu_du_moulin_boura_Project.PrjPcb
jeu_du_moulin_boura/pcb/jeu_du_moulin_boura_TouchPAD_SCH.SchDoc
jeu_du_moulin_boura/pcb/jeu_du_moulin_boura_uP_SCH.SchDoc
