boura01/jeu_du_moulin_2025_boura/jeu_du_moulin_boura/fwr/jeu_moulin_L072CZU6/Core/Inc/main.h

#define CS_G1_Pin GPIO_PIN_0
#define CS_G1_GPIO_Port GPIOA
#define L1_Pin GPIO_PIN_1
#define L1_GPIO_Port GPIOA
#define C3_Pin GPIO_PIN_2
#define C3_GPIO_Port GPIOA
#define C2_Pin GPIO_PIN_3
#define C2_GPIO_Port GPIOA
#define CS_G2_Pin GPIO_PIN_4
#define CS_G2_GPIO_Port GPIOA
#define L8_Pin GPIO_PIN_5
#define L8_GPIO_Port GPIOA
#define L7_Pin GPIO_PIN_6
#define L7_GPIO_Port GPIOA
#define C1_Pin GPIO_PIN_7
#define C1_GPIO_Port GPIOA
#define CS_G3_Pin GPIO_PIN_0
#define CS_G3_GPIO_Port GPIOB
#define L6_Pin GPIO_PIN_1
#define L6_GPIO_Port GPIOB
#define L5_Pin GPIO_PIN_2
#define L5_GPIO_Port GPIOB
#define L5_LED_Pin GPIO_PIN_10
#define L5_LED_GPIO_Port GPIOB
#define L4_LED_Pin GPIO_PIN_11
#define L4_LED_GPIO_Port GPIOB
#define C1_LED_Pin GPIO_PIN_8
#define C1_LED_GPIO_Port GPIOA
#define CS_G4_Pin GPIO_PIN_9
#define CS_G4_GPIO_Port GPIOA
#define L4_Pin GPIO_PIN_10
#define L4_GPIO_Port GPIOA
#define L3_Pin GPIO_PIN_11
#define L3_GPIO_Port GPIOA
#define L2_Pin GPIO_PIN_12
#define L2_GPIO_Port GPIOA
#define L3_LED_Pin GPIO_PIN_15
#define L3_LED_GPIO_Port GPIOA
#define C3_LED_Pin GPIO_PIN_3
#define C3_LED_GPIO_Port GPIOB
#define L2_LED_Pin GPIO_PIN_4
#define L2_LED_GPIO_Port GPIOB
#define C2_LED_Pin GPIO_PIN_5
#define C2_LED_GPIO_Port GPIOB
#define L1_LED_Pin GPIO_PIN_6
#define L1_LED_GPIO_Port GPIOB
#define L8_LED_Pin GPIO_PIN_7
#define L8_LED_GPIO_Port GPIOB
#define L7_LED_Pin GPIO_PIN_8
#define L7_LED_GPIO_Port GPIOB
#define L6_LED_Pin GPIO_PIN_9
#define L6_LED_GPIO_Port GPIOB
