boura01/jeu_du_moulin_2025_boura/(commit log)

2025-05-12 Mise a jour du schéma
    Rajout et création des éléments manquant sur Altium, documentation et remplissage du carnet journalier
    [jeu-du-moulin-bourquenouda-rpt-journal.xlsx, jeu_du_moulin_boura_LedMatrix_SCH.SchDoc, jeu_du_moulin_boura_PCB.PcbDoc, jeu_du_moulin_boura_Project.PrjPcb, jeu_du_moulin_boura_SCH.SchDoc, jeu_du_moulin_boura_TouchPAD_SCH.SchDoc, jeu_du_moulin_boura_uP_SCH.SchDoc]
2025-05-12 Modification Fichier Altium et STM32CubeIDE
    changements du schéma et création d'un fichier pour tester le programme STM32CubeIDE avec le MCU correcte
    [jeu_du_moulin_boura_LedMatrix_SCH.SchDoc, jeu_du_moulin_boura_Project.PrjPcb, jeu_du_moulin_boura_TouchPAD_SCH.SchDoc, jeu_du_moulin_boura_uP_SCH.SchDoc]
2025-05-12 Changement du Schéma
    j'ai continué de faire des changements dans le schéma à l'aide de STM32CubeIDE pour savoir quelles PINs sont utilisables pour les touches capacitives, capacité d'échantillonnage et les LEDs
    [jeu_du_moulin_boura_uP_SCH.SchDoc]
2025-05-14 changement du schéma Altium
    changement de plusieurs éléments sur altium ce qui nous rapproche de la version "fonctionnel" (en théorie)
    [jeu-du-moulin-bourquenouda-rpt-journal.xlsx, jeu_du_moulin_boura_LedMatrix_SCH.SchDoc, jeu_du_moulin_boura_Project.PrjPcb, jeu_du_moulin_boura_TouchPAD_SCH.SchDoc, jeu_du_moulin_boura_uP_SCH.SchDoc]
2025-05-14 Modifications Altium et sur la doc
    J'ai ajouté toutes les empreintes nécessaires et fait les changement dans la documentation par rapport au dimensionnement
    [Jeu_du_mouling_2025_planning.xlsx, jeu-du-moulin-bourquenouda-rpt-journal.xlsx, jeu_du_moulin_boura_LedMatrix_SCH.SchDoc, jeu_du_moulin_boura_TouchPAD_SCH.SchDoc, jeu_du_moulin_boura_uP_SCH.SchDoc]
2025-05-15 Changement principalement sur altium
    avancement du routage (les touches sont toutes routées, la majorité des composants sont placées). changement dans la BOM et dans les empreintes pour la MOSFET channel P
    [jeu-du-moulin-bourquenouda-rpt-journal.xlsx, jeu_du_moulin_boura_LedMatrix_SCH.SchDoc, jeu_du_moulin_boura_PCB.PcbDoc, jeu_du_moulin_boura_Project.PrjPcb, jeu_du_moulin_boura_TouchPAD_SCH.SchDoc, jeu_du_moulin_boura_uP_SCH.SchDoc]
2025-05-16 routage quasiment fini
    J'ai continué le routage et il est pratiquement terminé. il y a juste un "problème" au quel j'attends une réponse.
    [jeu-du-moulin-bourquenouda-rpt-journal.xlsx, jeu_du_moulin_boura_Project.PrjPcb, jeu_du_moulin_boura_uP_SCH.SchDoc]
2025-05-16 changement BOM et journal de travail
    complétion de la semaine 1 de travail et modification de la BOM pour inclure le changement de uC
    [jeu-du-moulin-bourquenouda-rpt-journal.xlsx, jeu_du_moulin_boura_uP_SCH.SchDoc]
2025-05-19 Changement des plans sur altium.
    J'ai du changer les plans en 2 plans de masse. J'ai donc du refaire une partie du routage pour corriger cette erreur. -> j'avais a plan de masse et 1 plan de VCC avant.
    [BOM_Modifiee.xlsx, jeu-du-moulin-bourquenouda-rpt-journal.xlsx, jeu_du_moulin_boura_LedMatrix_SCH.SchDoc, jeu_du_moulin_boura_PCB.PcbDoc, jeu_du_moulin_boura_Project.PrjPcb, jeu_du_moulin_boura_Project.xlsx, jeu_du_moulin_boura_TouchPAD_SCH.SchDoc, jeu_du_moulin_boura_uP_SCH.SchDoc]
2025-05-20 Finission PCB et documentation
    Ajout des modifications finales du PCB et ajout de plusieurs éléments dans la doc.
    [jeu-du-moulin-bourquenouda-rpt-journal.xlsx, jeu_du_moulin_boura_PCB.PcbDoc, jeu_du_moulin_boura_Project.PrjPcb, jeu_du_moulin_boura_uP_SCH.SchDoc]
2025-05-21 création des gerber
    création des gerbers et test sur eurocircuit ainsi que rédaction de la doc entre autre
    [jeu-du-moulin-bourquenouda-rpt-journal.xlsx, jeu_du_moulin_boura_LedMatrix_SCH.SchDoc, jeu_du_moulin_boura_PCB.PcbDoc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]
2025-05-22 Modification finales du PCB et création des Gerber
    J'ai fini les dernier changements de routage pour les LEDs en dessous des touches et la convenance à la classe 6C de Eurocircuit puis j'ai fini les gerbers
    [jeu-du-moulin-bourquenouda-rpt-journal.xlsx, jeu_du_moulin_boura_PCB.PcbDoc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]
2025-05-22 début de la programmation sur le STM32
    tests pour apprendre le fonctionnement de l'IDE de STM32
    [JEU_MOULIN_LQFP64 Debug.cfg, jeu-du-moulin-bourquenouda-rpt-journal.xlsx, jeu_du_moulin_boura_PCB.PcbDoc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]
2025-05-23 Changements au Gerber
    J'avais fait une erreur qui conduisait mes gerber a ne pas inclure de pochoir sur la face BOTTOM. J'ai changer ça et fait une release de la première version du PVB
    [jeu-du-moulin-bourquenouda-rpt-journal.xlsx, jeu_du_moulin_boura_PCB.PcbDoc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]
2025-05-23 Programmation
    J'ai fait une bonne partie de la prog avec le matériel que j'ai pour l'instant. Je peux allumer les LEDs une à une
    [BOM_Modifiee.xlsx, jeu-du-moulin-bourquenouda-rpt-journal.xlsx]
2025-05-28 programmation et documentation
    j'ai fini la programmation pour mon proto et celui de M.Egli et j'ai avancé la doc
    [jeu-du-moulin-bourquenouda-rpt-journal.xlsx, jeu_du_moulin_boura_PCB.PcbDoc]
2025-05-30 montage et ESSAIE de programmation du prototype
    j'ai fait la mise en service et j'ai monter le proto puis j'ai essayer de le faire marcher
    [jeu-du-moulin-bourquenouda-rpt-journal.xlsx, jeu_moulin_L072CZU6_test Debug.cfg]
2025-06-01 programmation
    J'ai changer pas mal de code pour faire fonctionner les LEDs. J'ai encore des problèmes avec les touches.
    [jeu_du_moulin_boura_PCB.PcbDoc]
2025-06-01 changements de la doc et du code
    changement du code pour les touchkeys et amélioration de la doc
    [jeu_du_moulin_boura_Project.xlsx]
2025-06-02 changement du code
    essaye pour résoudre le problème de touche sensing
    [jeu-du-moulin-bourquenouda-rpt-journal.xlsx, jeu_moulin_L072CZU6_test Debug.cfg]
2025-06-03 programmation et doc
    J'ai avancer la documentation et compris pourquoi les touches ne marchaient pas.
    [jeu-du-moulin-bourquenouda-rpt-journal.xlsx, jeu_du_moulin_boura_Project.PrjPcb, jeu_du_moulin_boura_TouchPAD_SCH.SchDoc]
2025-06-04 Changements dans la doc et dans le code
    Ajout de beaucoup d'élements dans la documentation et changement du fonctionnement du code pour essayer de faire fonctionner les touches capacitives
    [jeu-du-moulin-bourquenouda-rpt-journal.xlsx, jeu_du_moulin_boura_PCB.PcbDoc, jeu_du_moulin_boura_Project.xlsx, jeu_du_moulin_boura_uP_SCH.SchDoc]
