boura01/jeu_du_moulin_2025_boura/(notices)

Notices in the files:
jeu_du_moulin_boura/fwr/jeu_moulin_L072CZU6/Core/Inc/main.h:
Copyright (c) 2025 STMicroelectronics.
All rights reserved.
This software is licensed under terms that can be found in the LICENSE file
